Tomas-Kuchta-FPV/VESC6_OPEN_HARDWARE/BOM.csv

Index | LCSC# | MPN | Manufacturer | Package | Customer # | Description | Quantity | MOQ | Multiple | Unit Price($) | Extended Price($) | Product Link
1 | C22775 | 0603WAF1000T5E | UNI-ROYAL | 603 |  | 100Ω ±1% 100mW 0603 Thick Film Resistor | 100 | 100 | 100 | 0 | 0 | https://www.lcsc.com/product-detail/C22775.html
2 | C501008 | STL130N6F7 | ST | PowerFLAT-5x6 |  | N-Channel 60V 130A 125W Surface Mount PowerFLAT-5x6 | 12 | 1 | 1 | 0.9575 | 11.49 | https://www.lcsc.com/product-detail/C501008.html
3 | C22787 | 0603WAF1200T5E | UNI-ROYAL | 603 |  | 120Ω ±1% 100mW 0603 Thick Film Resistor | 100 | 100 | 100 | 0.0019 | 0.19 | https://www.lcsc.com/product-detail/C22787.html
4 | C22978 | 0603WAF3301T5E | UNI-ROYAL | 603 |  | 3.3kΩ ±1% 100mW 0603 Thick Film Resistor | 100 | 100 | 100 | 0.0022 | 0.22 | https://www.lcsc.com/product-detail/C22978.html
5 | C25810 | 0603WAF1802T5E | UNI-ROYAL | 603 |  | 18kΩ ±1% 100mW 0603 Thick Film Resistor | 100 | 100 | 100 | 0 | 0 | https://www.lcsc.com/product-detail/C25810.html
6 | C22809 | 0603WAF1502T5E | UNI-ROYAL | 603 |  | 15kΩ ±1% 100mW 0603 Thick Film Resistor | 100 | 100 | 100 | 0.0029 | 0.29 | https://www.lcsc.com/product-detail/C22809.html
7 | C25804 | 0603WAF1002T5E | UNI-ROYAL | 603 |  | 10kΩ ±1% 100mW 0603 Thick Film Resistor | 100 | 100 | 100 | 0.0022 | 0.22 | https://www.lcsc.com/product-detail/C25804.html
8 | C22961 | 0603WAF2203T5E | UNI-ROYAL | 603 |  | 220kΩ ±1% 100mW 0603 Thick Film Resistor | 100 | 100 | 100 | 0 | 0 | https://www.lcsc.com/product-detail/C22961.html
9 | C23153 | 0603WAF3902T5E | UNI-ROYAL | 603 |  | 39kΩ ±1% 100mW 0603 Thick Film Resistor | 100 | 100 | 100 | 0.0023 | 0.23 | https://www.lcsc.com/product-detail/C23153.html
10 | C4190 | 0603WAF2201T5E | UNI-ROYAL | 603 |  | 2.2kΩ ±1% 100mW 0603 Thick Film Resistor | 100 | 100 | 100 | 0.0018 | 0.18 | https://www.lcsc.com/product-detail/C4190.html
11 | C469426 | ASR-M-3-0.5F | Yezhan | 2512 |  | 6W 0.5mΩ Shunt ±1% ±115ppm/℃ 2512 Chip Resistor - Surface Mount | 10 | 5 | 5 | 0.2714 | 2.71 | https://www.lcsc.com/product-detail/C469426.html
12 | C23164 | 0603WAF470KT5E | UNI-ROYAL | 603 |  | 4.7Ω ±1% 100mW 0603 Thick Film Resistor | 100 | 100 | 100 | 0.0027 | 0.27 | https://www.lcsc.com/product-detail/C23164.html
13 | C160392 | BM06B-SRSS-TB(LF)(SN) | JST | SMD,P=1mm |  | Connector Header 6 position 1mm Pitch 1A Surface Mount,Vertical -25℃~+85℃ | 5 | 5 | 5 | 0.3548 | 1.77 | https://www.lcsc.com/product-detail/C160392.html
14 | C76589 | NTCG163JF103FT1 | TDK | 603 |  | NTC Thermistor 10kΩ Surface Mount 0603 | 5 | 5 | 5 | 0.2086 | 1.04 | https://www.lcsc.com/product-detail/C76589.html
15 | C84375 | RC0805FR-075K1L | YAGEO | 805 |  | 5.1kΩ 125mW 150V Thick Film Resistor ±100ppm/℃ ±1% 0805 Chip Resistor - Surface Mount RoHS | 100 | 100 | 100 | 0.0072 | 0.72 | https://www.lcsc.com/product-detail/C84375.html
16 | C23345 | 0603WAF220JT5E | UNI-ROYAL | 603 |  | 22Ω ±1% 100mW 0603 Thick Film Resistor | 100 | 100 | 100 | 0.0017 | 0.17 | https://www.lcsc.com/product-detail/C23345.html
17 | C124020 | TJA1051TK/3,118 | NXP | HVSON-8-EP(3x3) |  | 4.5V~5.5V CAN FD Transceiver 5Mbps HVSON-8-EP(3x3) Drivers, Receivers, Transceivers RoHS | 2 | 1 | 1 | 1.9139 | 3.83 | https://www.lcsc.com/product-detail/C124020.html
18 | C477918 | LM3671MFX-3.3/NOPB | TI | SOT-23-5 |  | 2MHz Step-down type Fixed 3.3V 600mA SOT-23-5 Voltage Regulators - DC DC Switching Regulators RoHS | 2 | 1 | 1 | 1.0763 | 2.15 | https://www.lcsc.com/product-detail/C477918.html
19 | C98969 | DRV8301DCAR | TI | HTSSOP-56-6mm |  | Three Phase 6V~60V MOSFET 1.7A 25ns 25ns 2.3A HTSSOP-56-6mm Motor Drivers, Controllers RoHS | 2 | 1 | 1 | 4.4178 | 8.84 | https://www.lcsc.com/product-detail/C98969.html
20 | C495342 | AD8418WBRZ-RL | ADI | SOIC-8 |  | 1 -2V~70V 200uV 1V/us 100dB 2.6mA 20V/V SOIC-8 Instrumentation, Op Amps, Buffer Amps RoHS | 6 | 1 | 1 | 5.6955 | 34.17 | https://www.lcsc.com/product-detail/C495342.html
21 | C2827654 | USBLC6-2SC6 | TECH PUBLIC | SOT-23-6 |  | 12VC Clamp 6A Ipp ESD DIODE SOT-23-6 | 10 | 10 | 10 | 0.0452 | 0.45 | https://www.lcsc.com/product-detail/C2827654.html
22 | C15742 | STM32F405RGT6 | ST | LQFP-64(10x10) |  | ARM Cortex-M4 32 Bit 168MHz LQFP-64(10x10) Microcontrollers RoHS | 2 | 1 | 1 | 6.946 | 13.89 | https://www.lcsc.com/product-detail/C15742.html
23 | C115962 | X50328MSB2GI | YXC Crystal Oscillators | SMD5032-2P |  | Crystal 8MHz ±10ppm 20pF SMD5032-2P | 10 | 10 | 10 | 0.2488 | 2.49 | https://www.lcsc.com/product-detail/C115962.html
24 | C2923951 | DSS26 | JSCJ | SOD-123FL |  | Diode Independent 60V 2A Surface Mount SOD-123FL | 10 | 10 | 10 | 0.0518 | 0.52 | https://www.lcsc.com/product-detail/C2923951.html
25 | C1631 | 0603B682K500NT | FH | 603 |  | 6.8nF ±10% 50V Ceramic Capacitor X7R 0603 | 100 | 100 | 100 | 0.0056 | 0.56 | https://www.lcsc.com/product-detail/C1631.html
26 | C107035 | CC0603JRNPO9BN121 | YAGEO | 603 |  | 120pF ±5% 50V Ceramic Capacitor NP0 0603 | 100 | 100 | 100 | 0.0053 | 0.53 | https://www.lcsc.com/product-detail/C107035.html
27 | C21122 | CL10B223KB8NNNC | Samsung Electro-Mechanics | 603 |  | 22nF ±10% 50V Ceramic Capacitor X7R 0603 | 50 | 50 | 50 | 0.0058 | 0.29 | https://www.lcsc.com/product-detail/C21122.html
28 | C16133 | TAJB107K006RNJ | Kyocera AVX | CASE-B-3528-21(mm) |  | 100uF ±10% 6.3V Tantalum Capacitors 1.7Ω@100kHz CASE-B-3528-21(mm) | 4 | 2 | 2 | 0.5706 | 2.28 | https://www.lcsc.com/product-detail/C16133.html
29 | C1596 | 0603B153K500NT | FH | 603 |  | 15nF ±10% 50V Ceramic Capacitor X7R 0603 | 50 | 50 | 50 | 0.0094 | 0.47 | https://www.lcsc.com/product-detail/C1596.html
30 | C385987 | HMK325C7475KM-PE | Taiyo Yuden | 1210 |  | 4.7uF ±10% 100V Ceramic Capacitor X7S 1210 | 20 | 5 | 5 | 0.3209 | 6.42 | https://www.lcsc.com/product-detail/C385987.html
31 | C21120 | CL10B224KA8NNNC | Samsung Electro-Mechanics | 603 |  | 220nF ±10% 25V Ceramic Capacitor X7R 0603 | 50 | 50 | 50 | 0.0094 | 0.47 | https://www.lcsc.com/product-detail/C21120.html
32 | C14663 | CC0603KRX7R9BB104 | YAGEO | 603 |  | 100nF ±10% 50V Ceramic Capacitor X7R 0603 | 50 | 50 | 50 | 0.0087 | 0.44 | https://www.lcsc.com/product-detail/C14663.html
33 | C53987 | 0603B472K500NT | FH | 603 |  | 4.7nF ±10% 50V Ceramic Capacitor X7R 0603 | 50 | 50 | 50 | 0.0054 | 0.27 | https://www.lcsc.com/product-detail/C53987.html
34 | C1644 | CL10C150JB8NNNC | Samsung Electro-Mechanics | 603 |  | 15pF ±5% 50V Ceramic Capacitor C0G 0603 | 50 | 50 | 50 | 0.0112 | 0.56 | https://www.lcsc.com/product-detail/C1644.html
35 | C7471900 | 189RV0038 | KNSCHA | SMD,D10xL10.5mm |  | 220uF ±20% 63V Aluminum Electrolytic Capacitors 2000hrs@105℃ | 5 | 5 | 5 | 0.1171 | 0.59 | https://www.lcsc.com/product-detail/C7471900.html
36 | C23630 | CL10A225KO8NNNC | Samsung Electro-Mechanics | 603 |  | 2.2uF ±10% 16V Ceramic Capacitor X5R 0603 | 50 | 50 | 50 | 0.0123 | 0.62 | https://www.lcsc.com/product-detail/C23630.html
37 | C129544 | SMAJ5.0A-TP | MCC | DO-214AC(SMA) |  | 9.2VC Clamp 43.5A@10/1000us Ipp TVS DIODE DO-214AC(SMA) | 5 | 5 | 5 | 0.1112 | 0.56 | https://www.lcsc.com/product-detail/C129544.html
38 | C2286 | KT-0603R | Hubei KENTO Elec | 603 |  | Red 645nm LED Indication - Discrete 2.4V 0603 | 100 | 100 | 100 | 0.0077 | 0.77 | https://www.lcsc.com/product-detail/C2286.html
39 | C2290 | KT-0603W | Hubei KENTO Elec | 603 |  | White LED Indication - Discrete 2.6V~3.1V 0603 | 50 | 50 | 50 | 0.0123 | 0.62 | https://www.lcsc.com/product-detail/C2290.html
40 | C165948 | TYPE-C-31-M-12 | Korean Hroparts Elec | SMD |  | USB-C (USB TYPE-C) Receptacle Connector 16 Position Surface Mount | 5 | 5 | 5 | 0.1736 | 0.87 | https://www.lcsc.com/product-detail/C165948.html
41 | C383398 | MLZ2012A2R2WT000 | TDK | 805 |  | 650mA 2.2uH ±20% 210mA 150mΩ Multilayer inductor 0805 Fixed Inductors RoHS | 10 | 10 | 10 | 0.0483 | 0.48 | https://www.lcsc.com/product-detail/C383398.html
42 | C266430 | SMNR6028-220MT | Shun Xiang Nuo | SMD,6x6mm |  | 1.45A 22uH ±20% 1.45A 182mΩ Magnetic Shielded Inductor SMD,6x6mm Fixed Inductors | 5 | 5 | 5 | 0.0869 | 0.43 | https://www.lcsc.com/product-detail/C266430.html
43 | C7200700 | 8730 | Keystone | - |  | Tin 15A Brass M2.5 Screw Connectors RoHS | 8 | 1 | 1 | 0.7112 | 5.69 | https://www.lcsc.com/product-detail/C7200700.html
44 | C160404 | SM04B-SRSS-TB(LF)(SN) | JST | SMD,P=1mm,Surface Mount,Right Angle |  | Connector Header 4 position 1mm Pitch 1A Surface Mount, Right Angle -25℃~+85℃ | 5 | 5 | 5 | 0.2168 | 1.08 | https://www.lcsc.com/product-detail/C160404.html
45 | C160405 | SM06B-SRSS-TB(LF)(SN) | JST | SMD,P=1mm,Surface Mount,Right Angle |  | Connector Header 6 position 1mm Pitch 1A Surface Mount, Right Angle -25℃~+85℃ | 3 | 1 | 1 | 0.9021 | 2.71 | https://www.lcsc.com/product-detail/C160405.html
46 | C160390 | BM04B-SRSS-TB(LF)(SN) | JST | SMD,P=1mm |  | Connector Header 4 position 1mm Pitch 1A Surface Mount,Vertical -25℃~+85℃ | 5 | 5 | 5 | 0.2559 | 1.28 | https://www.lcsc.com/product-detail/C160390.html
 |  |  |  |  |  | LCSC Shipping |  |  |  |  | 13.24
 |  |  |  |  |  | LCSC VAT and taxes |  |  |  |  | 38.85
 |  |  |  |  |  | JLCPCB |  |  |  |  | 38.42
 |  |  |  |  |  | JLCPCB Shipping |  |  |  |  | 11.86
 |  |  |  |  |  | JLCPCB tarif |  |  |  |  | 21.76
