Tomas-Kuchta-FPV/VESC6_OPEN_HARDWARE/VESC6_OPEN_HARDWARE.kicad_pcb

## KiCad design VESC6_OPEN_HARDWARE.kicad_pcb (2026-10-29)

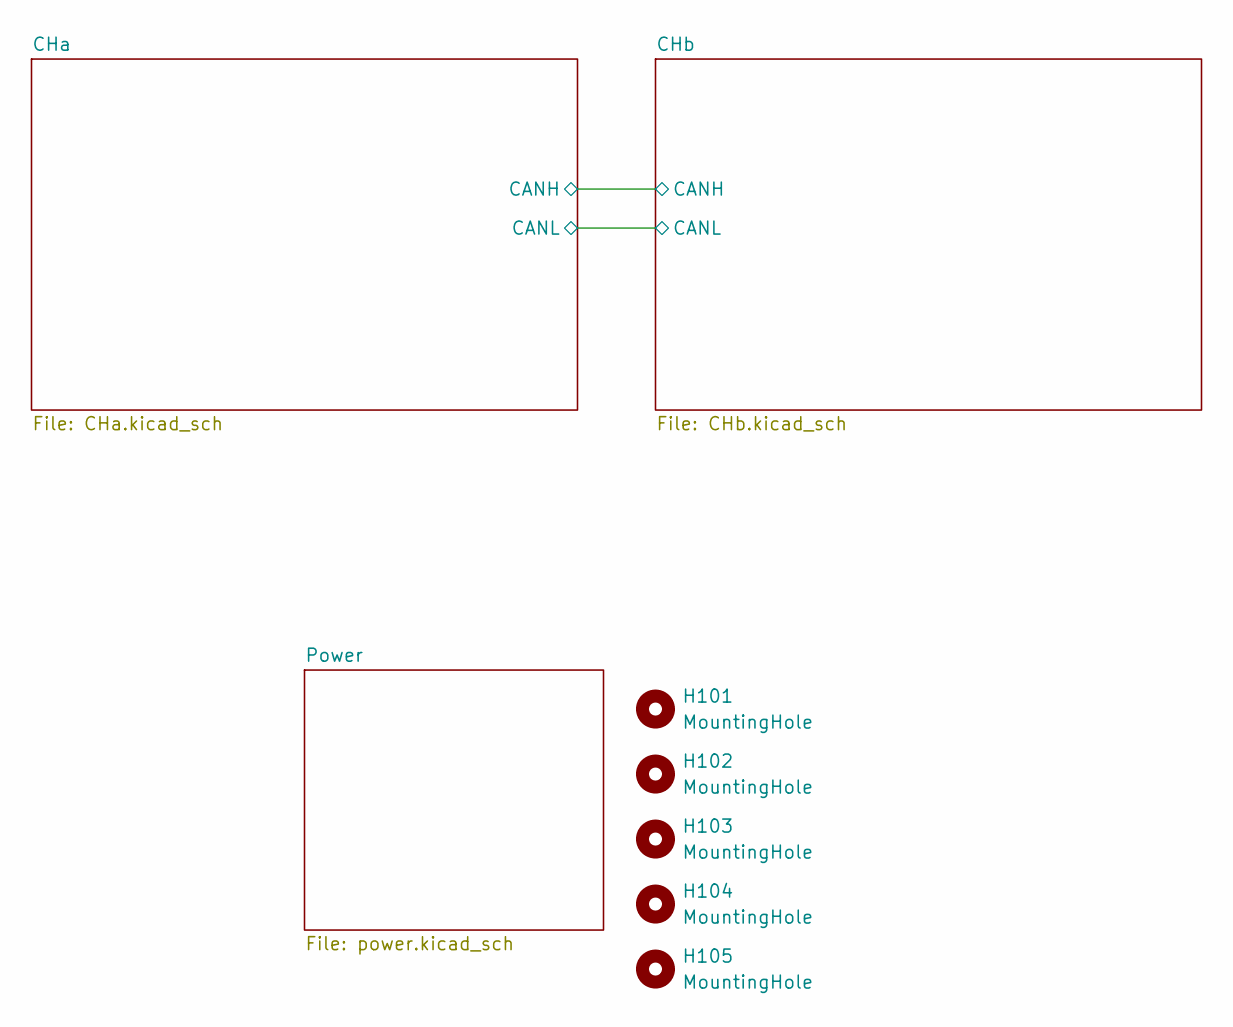
[picture p3: schematic VESC6_OPEN_HARDWARE.kicad_sch]

Parts:
H101, H102, H103, H104, H105: MountingHole; MountingHole_3mm

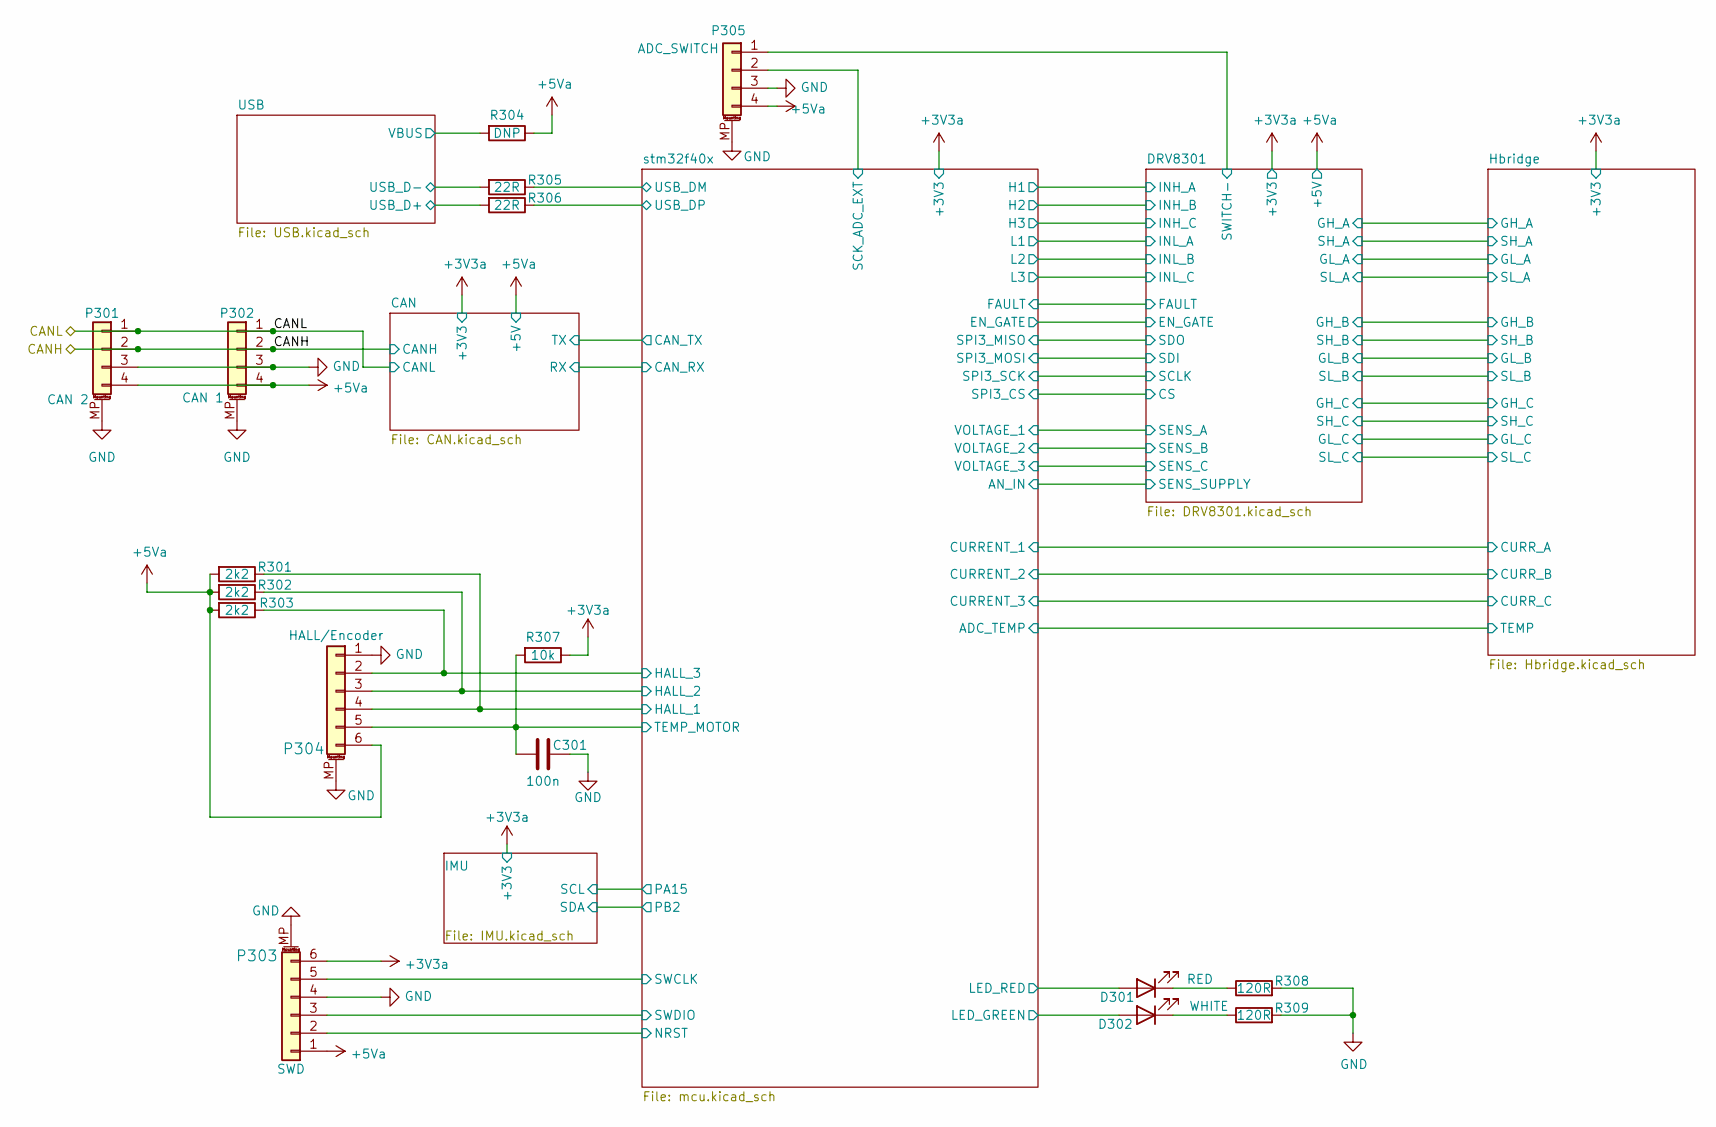
[picture p4: schematic CHa.kicad_sch]

Parts:
C301: 100n; C_0603_1608Metric; LCSC C14663
D301: RED; D_0603_1608Metric; LCSC C2286
D302: WHITE; D_0603_1608Metric; LCSC C2290
P301: CAN 2; JST_SH_SM04B-SRSS-TB_1x04-1MP_P1.00mm_Horizontal; LCSC C160404
P302: CAN 1; JST_SH_SM04B-SRSS-TB_1x04-1MP_P1.00mm_Horizontal; LCSC C160404
P303: SWD; JST_SH_SM06B-SRSS-TB_1x06-1MP_P1.00mm_Horizontal; LCSC C160405
P304: HALL/Encoder; JST_SH_SM06B-SRSS-TB_1x06-1MP_P1.00mm_Horizontal; LCSC C160405
P305: ADC_SWITCH; JST_SH_SM04B-SRSS-TB_1x04-1MP_P1.00mm_Horizontal; LCSC C160404
R301, R302, R303: 2k2; R_0603_1608Metric; LCSC C4190
R304: DNP; R_0603_1608Metric
R305, R306: 22R; R_0603_1608Metric; LCSC C23345
R307: 10k; R_0603_1608Metric; LCSC C25804
R308, R309: 120R; R_0603_1608Metric; LCSC C22787

Connections:
+3V3a: P303.6, R307.1; also elsewhere on the board
+5Va: P301.4, P302.4, P303.1, P304.6, P305.4, R301.2, R302.2, R303.2, R304.1; also elsewhere on the board
/CHa/CANH: P301.2, P302.2; also elsewhere on the board
/CHa/CANL: P301.1, P302.1; also elsewhere on the board
/CHa/DRV8301/SWITCH-: P305.1; also elsewhere on the board
/CHa/USB/USB_D+: R306.2; also elsewhere on the board
/CHa/USB/USB_D-: R305.2; also elsewhere on the board
/CHa/USB/VBUS: R304.2; also elsewhere on the board
/CHa/stm32f40x/HALL_1: P304.4, R301.1; also elsewhere on the board
/CHa/stm32f40x/HALL_2: P304.3, R302.1; also elsewhere on the board
/CHa/stm32f40x/HALL_3: P304.2, R303.1; also elsewhere on the board
/CHa/stm32f40x/LED_GREEN: D302.2 (A); also elsewhere on the board
/CHa/stm32f40x/LED_RED: D301.2 (A); also elsewhere on the board
/CHa/stm32f40x/NRST: P303.2; also elsewhere on the board
/CHa/stm32f40x/SCK_ADC_EXT: P305.2; also elsewhere on the board
/CHa/stm32f40x/SWCLK: P303.5; also elsewhere on the board
/CHa/stm32f40x/SWDIO: P303.3; also elsewhere on the board
/CHa/stm32f40x/TEMP_MOTOR: C301.2, P304.5, R307.2; also elsewhere on the board
/CHa/stm32f40x/USB_DM: R305.1; also elsewhere on the board
/CHa/stm32f40x/USB_DP: R306.1; also elsewhere on the board
GND: C301.1, P301.3, P301.MP (MountPin), P302.3, P302.MP (MountPin), P303.4, P303.MP (MountPin), P304.1, P304.MP (MountPin), P305.3, P305.MP (MountPin), R308.2, R309.2; also elsewhere on the board
unnamed: D301.1 (K), R308.1
unnamed: D302.1 (K), R309.1

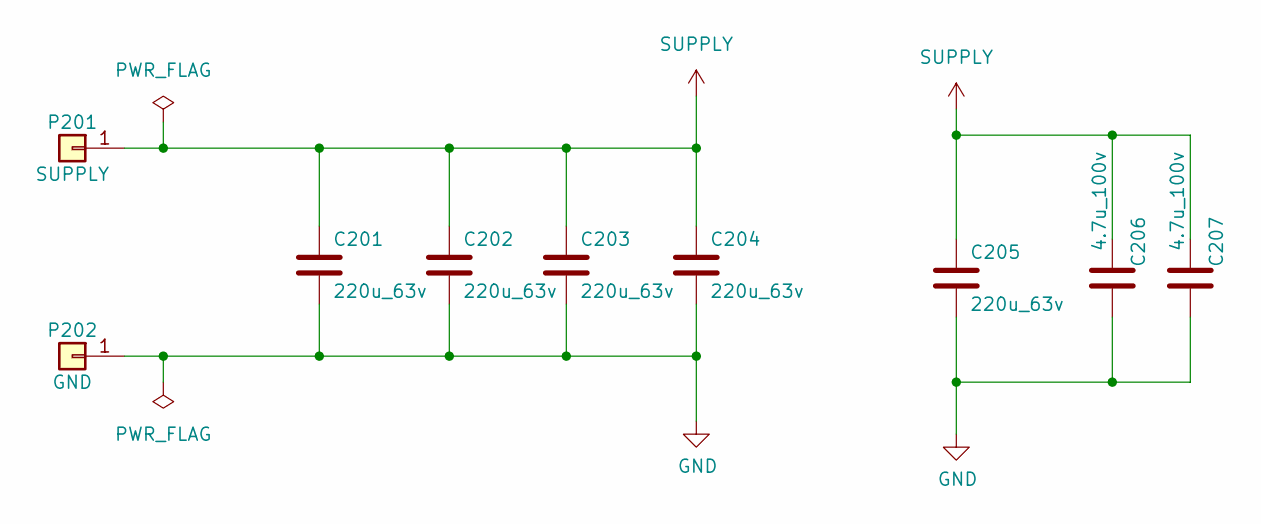
[picture p5: schematic power.kicad_sch]

Parts:
C201, C202, C203, C204, C205: 220u_63v; CP_Elec_10x10.5; LCSC C7471900
C206, C207: 4.7u_100v; C_1210_3225Metric; LCSC C385987
P201: SUPPLY; Pin_D1.3mm_L11.0mm_LooseFit; LCSC C7200700
P202: GND; Pin_D1.3mm_L11.0mm_LooseFit; LCSC C7200700

Connections:
GND: C201.2, C202.2, C203.2, C204.2, C205.2, C206.2, C207.2, P202.1 (Pin_1_1); also elsewhere on the board
SUPPLY: C201.1, C202.1, C203.1, C204.1, C205.1, C206.1, C207.1, P201.1 (Pin_1_1); also elsewhere on the board

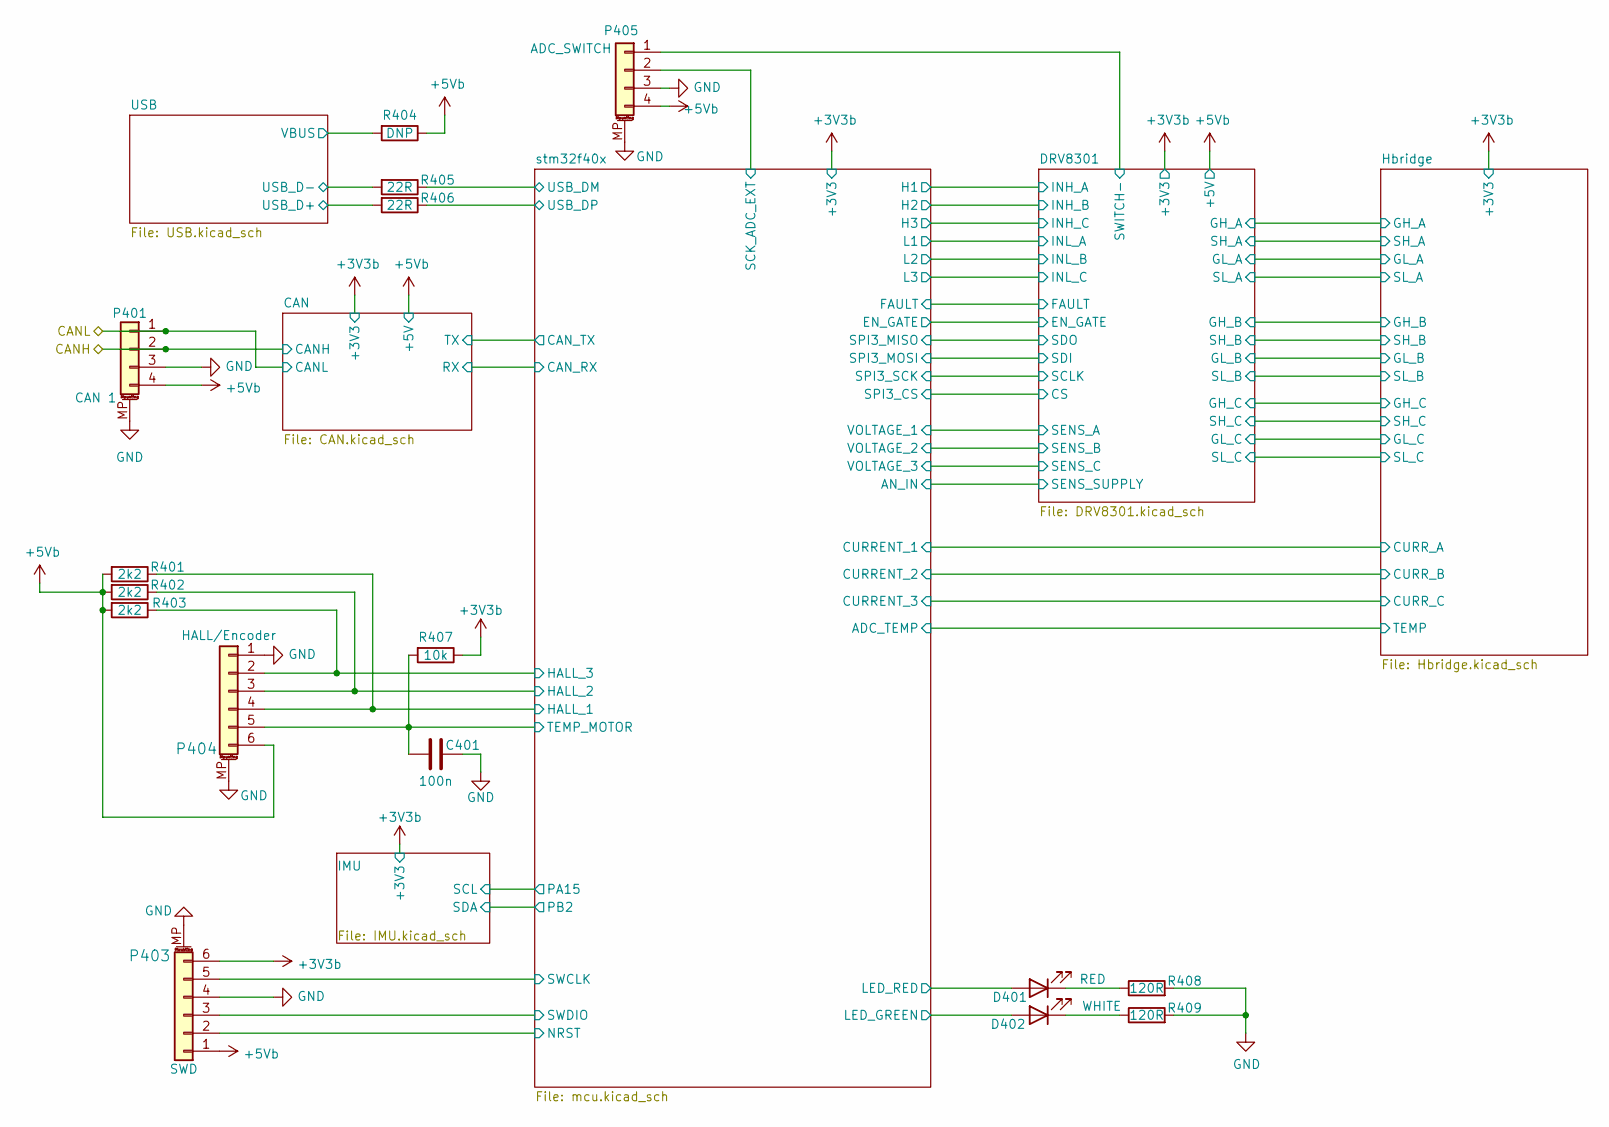
[picture p6: schematic CHb.kicad_sch]

Parts:
C401: 100n; C_0603_1608Metric; LCSC C14663
D401: RED; D_0603_1608Metric; LCSC C2286
D402: WHITE; D_0603_1608Metric; LCSC C2290
P401: CAN 1; JST_SH_BM04B-SRSS-TB_1x04-1MP_P1.00mm_Vertical; LCSC C160390
P403: SWD; JST_SH_BM06B-SRSS-TB_1x06-1MP_P1.00mm_Vertical; LCSC C160392
P404: HALL/Encoder; JST_SH_SM06B-SRSS-TB_1x06-1MP_P1.00mm_Horizontal; LCSC C160405
P405: ADC_SWITCH; JST_SH_BM04B-SRSS-TB_1x04-1MP_P1.00mm_Vertical; LCSC C160390
R401, R402, R403: 2k2; R_0603_1608Metric; LCSC C4190
R404: DNP; R_0603_1608Metric
R405, R406: 22R; R_0603_1608Metric; LCSC C23345
R407: 10k; R_0603_1608Metric; LCSC C25804
R408, R409: 120R; R_0603_1608Metric; LCSC C22787

Connections:
+3V3b: P403.6, R407.1; also elsewhere on the board
+5Vb: P401.4, P403.1, P404.6, P405.4, R401.2, R402.2, R403.2, R404.1; also elsewhere on the board
/CHa/CANH: P401.2; also elsewhere on the board
/CHa/CANL: P401.1; also elsewhere on the board
/CHb/DRV8301/SWITCH-: P405.1; also elsewhere on the board
/CHb/USB/USB_D+: R406.2; also elsewhere on the board
/CHb/USB/USB_D-: R405.2; also elsewhere on the board
/CHb/USB/VBUS: R404.2; also elsewhere on the board
/CHb/stm32f40x/HALL_1: P404.4, R401.1; also elsewhere on the board
/CHb/stm32f40x/HALL_2: P404.3, R402.1; also elsewhere on the board
/CHb/stm32f40x/HALL_3: P404.2, R403.1; also elsewhere on the board
/CHb/stm32f40x/LED_GREEN: D402.2 (A); also elsewhere on the board
/CHb/stm32f40x/LED_RED: D401.2 (A); also elsewhere on the board
/CHb/stm32f40x/NRST: P403.2; also elsewhere on the board
/CHb/stm32f40x/SCK_ADC_EXT: P405.2; also elsewhere on the board
/CHb/stm32f40x/SWCLK: P403.5; also elsewhere on the board
/CHb/stm32f40x/SWDIO: P403.3; also elsewhere on the board
/CHb/stm32f40x/TEMP_MOTOR: C401.2, P404.5, R407.2; also elsewhere on the board
/CHb/stm32f40x/USB_DM: R405.1; also elsewhere on the board
/CHb/stm32f40x/USB_DP: R406.1; also elsewhere on the board
GND: C401.1, P401.3, P401.MP (MountPin), P403.4, P403.MP (MountPin), P404.1, P404.MP (MountPin), P405.3, P405.MP (MountPin), R408.2, R409.2; also elsewhere on the board
unnamed: D401.1 (K), R408.1
unnamed: D402.1 (K), R409.1

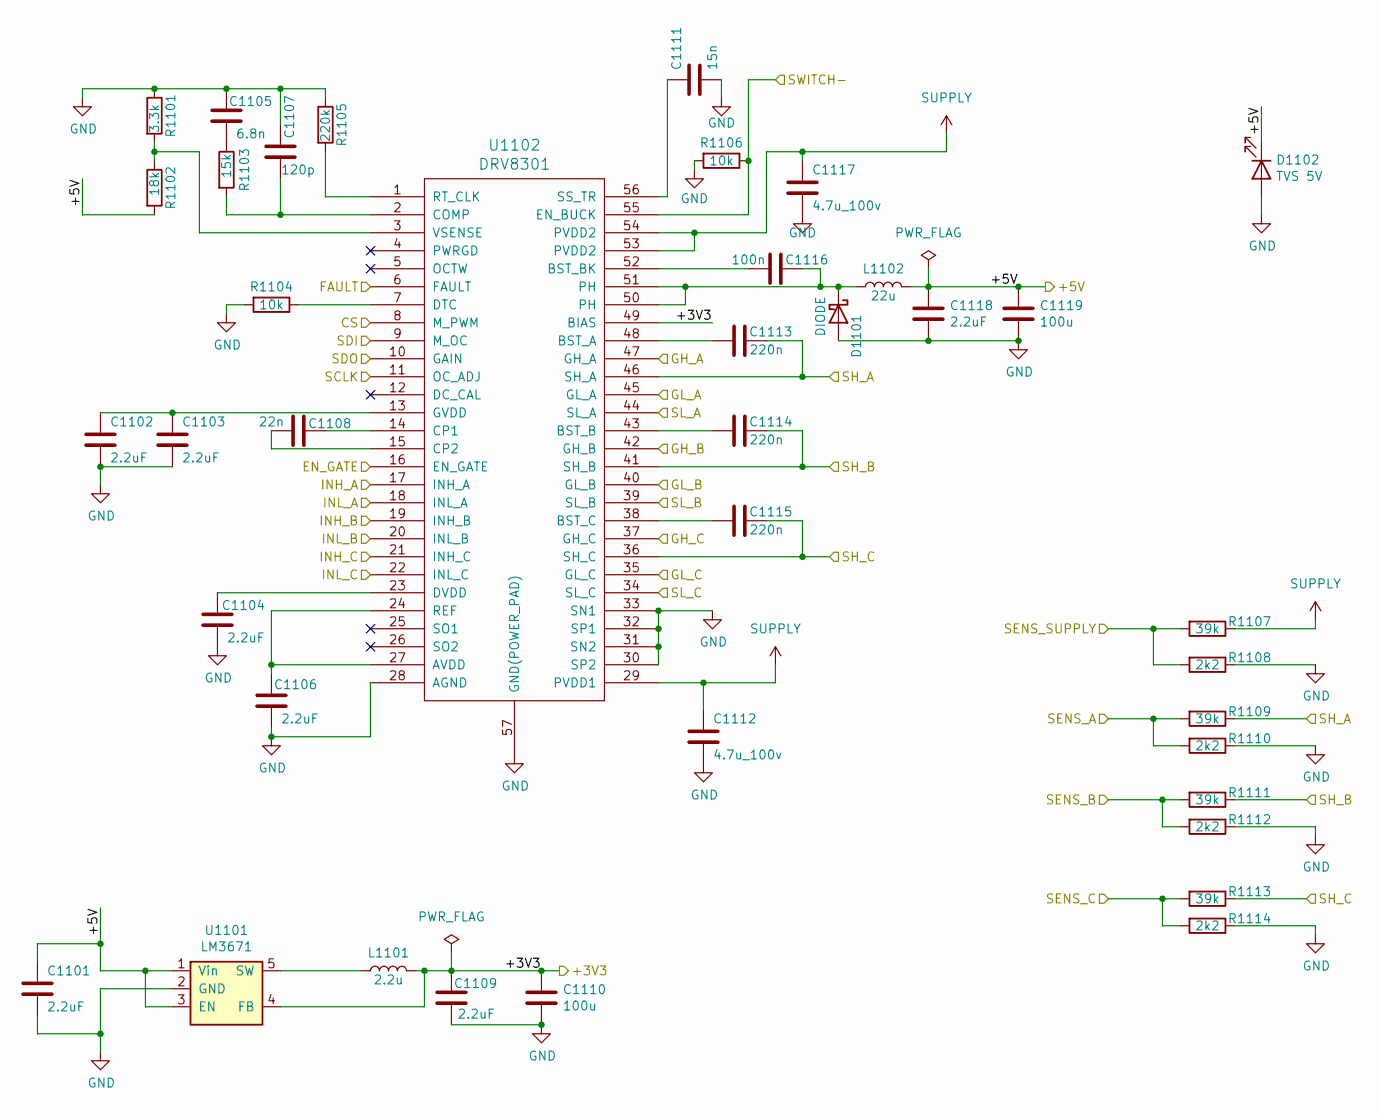
[picture p7: schematic DRV8301.kicad_sch]

Parts:
C1101, C1102, C1103, C1104, C1106, C1109, C1118: 2.2uF; C_0603_1608Metric; LCSC C23630
C1105: 6.8n; C_0603_1608Metric; LCSC C1631
C1107: 120p; C_0603_1608Metric; LCSC C107035
C1108: 22n; C_0603_1608Metric; LCSC C21122
C1110, C1119: 100u; C_1210_3225Metric; LCSC C16133
C1111: 15n; C_0603_1608Metric; LCSC C1596
C1112, C1117: 4.7u_100v; C_1210_3225Metric; LCSC C385987
C1113, C1114, C1115: 220n; C_0603_1608Metric; LCSC C21120
C1116: 100n; C_0603_1608Metric; LCSC C14663
D1101: DIODE; D_SMF; LCSC C2923951
D1102: TVS 5V; D_SMA; LCSC C129544
L1101: 2.2u; L_0805_2012Metric; LCSC C383398
L1102: 22u; L_Taiyo-Yuden_NR-60xx_HandSoldering; LCSC C266430
R1101: 3.3k; R_0603_1608Metric; LCSC C22978
R1102: 18k; R_0603_1608Metric; LCSC C25810
R1103: 15k; R_0603_1608Metric; LCSC C22809
R1104, R1106: 10k; R_0603_1608Metric; LCSC C25804
R1105: 220k; R_0603_1608Metric; LCSC C22961
R1107, R1109, R1111, R1113: 39k; R_0603_1608Metric; LCSC C23153
R1108, R1110, R1112, R1114: 2k2; R_0603_1608Metric; LCSC C4190
U1101: LM3671; SOT-23-5; LCSC C477918
U1102: DRV8301; HTSSOP-56-1EP_6.1x14mm_P0.5mm_EP3.61x6.35mm; LCSC C98969

Connections:
+3V3a: C1109.1, C1110.1, L1101.2, U1101.4 (FB), U1102.49 (BIAS); also elsewhere on the board
+5Va: C1101.1, C1118.1, C1119.1, D1102.1 (K), L1102.2, R1102.2, U1101.1 (Vin), U1101.3 (EN); also elsewhere on the board
/CHa/DRV8301/CS: U1102.8 (M_PWM); also elsewhere on the board
/CHa/DRV8301/EN_GATE: U1102.16 (EN_GATE); also elsewhere on the board
/CHa/DRV8301/FAULT: U1102.6 (FAULT); also elsewhere on the board
/CHa/DRV8301/GH_A: U1102.47 (GH_A); also elsewhere on the board
/CHa/DRV8301/GH_B: U1102.42 (GH_B); also elsewhere on the board
/CHa/DRV8301/GH_C: U1102.37 (GH_C); also elsewhere on the board
/CHa/DRV8301/GL_A: U1102.45 (GL_A); also elsewhere on the board
/CHa/DRV8301/GL_B: U1102.40 (GL_B); also elsewhere on the board
/CHa/DRV8301/GL_C: U1102.35 (GL_C); also elsewhere on the board
/CHa/DRV8301/INH_A: U1102.17 (INH_A); also elsewhere on the board
/CHa/DRV8301/INH_B: U1102.19 (INH_B); also elsewhere on the board
/CHa/DRV8301/INH_C: U1102.21 (INH_C); also elsewhere on the board
/CHa/DRV8301/INL_A: U1102.18 (INL_A); also elsewhere on the board
/CHa/DRV8301/INL_B: U1102.20 (INL_B); also elsewhere on the board
/CHa/DRV8301/INL_C: U1102.22 (INL_C); also elsewhere on the board
/CHa/DRV8301/SCLK: U1102.11 (OC_ADJ); also elsewhere on the board
/CHa/DRV8301/SDI: U1102.9 (M_OC); also elsewhere on the board
/CHa/DRV8301/SDO: U1102.10 (GAIN); also elsewhere on the board
/CHa/DRV8301/SENS_A: R1109.2, R1110.2; also elsewhere on the board
/CHa/DRV8301/SENS_B: R1111.2, R1112.2; also elsewhere on the board
/CHa/DRV8301/SENS_C: R1113.2, R1114.2; also elsewhere on the board
/CHa/DRV8301/SENS_SUPPLY: R1107.2, R1108.2; also elsewhere on the board
/CHa/DRV8301/SH_A: C1113.1, R1109.1, U1102.46 (SH_A); also elsewhere on the board
/CHa/DRV8301/SH_B: C1114.1, R1111.1, U1102.41 (SH_B); also elsewhere on the board
/CHa/DRV8301/SH_C: C1115.1, R1113.1, U1102.36 (SH_C); also elsewhere on the board
/CHa/DRV8301/SWITCH-: R1106.1, U1102.55 (EN_BUCK); also elsewhere on the board
GND: C1101.2, C1102.2, C1103.2, C1104.2, C1105.1, C1106.2, C1107.1, C1109.2, C1110.2, C1111.2, C1112.2, C1117.2, C1118.2, C1119.2, D1101.2 (A), D1102.2 (A), R1101.1, R1104.2, R1105.1, R1106.2, R1108.1, R1110.1, R1112.1, R1114.1, U1101.2 (GND), U1102.28 (AGND), U1102.30 (SP2), U1102.31 (SN2), U1102.32 (SP1), U1102.33 (SN1), U1102.34 (SL_C), U1102.39 (SL_B), U1102.44 (SL_A), U1102.57 (GND(POWER_PAD)); also elsewhere on the board
unnamed: C1105.2, R1103.1
unnamed: C1116.1, D1101.1 (K), L1102.1, U1102.50 (PH), U1102.51 (PH)
unnamed: L1101.1, U1101.5 (SW)
unnamed: C1106.1, U1102.24 (REF), U1102.27 (AVDD)
unnamed: C1113.2, U1102.48 (BST_A)
unnamed: C1114.2, U1102.43 (BST_B)
unnamed: C1116.2, U1102.52 (BST_BK)
unnamed: C1115.2, U1102.38 (BST_C)
unnamed: C1107.2, R1103.2, U1102.2 (COMP)
unnamed: C1108.1, U1102.14 (CP1)
unnamed: C1108.2, U1102.15 (CP2)
unnamed: R1104.1, U1102.7 (DTC)
unnamed: C1104.1, U1102.23 (DVDD)
unnamed: C1102.1, C1103.1, U1102.13 (GVDD)
unnamed: R1105.2, U1102.1 (RT_CLK)
unnamed: C1111.1, U1102.56 (SS_TR)
unnamed: R1101.2, R1102.1, U1102.3 (VSENSE)
SUPPLY: C1112.1, C1117.1, R1107.1, U1102.29 (PVDD1), U1102.53 (PVDD2), U1102.54 (PVDD2); also elsewhere on the board

Parts of its further copies:
C2101, C2102, C2103, C2104, C2106, C2109, C2118: 2.2uF; C_0603_1608Metric; LCSC C23630
C2105: 6.8n; C_0603_1608Metric; LCSC C1631
C2107: 120p; C_0603_1608Metric; LCSC C107035
C2108: 22n; C_0603_1608Metric; LCSC C21122
C2110, C2119: 100u; C_1210_3225Metric; LCSC C16133
C2111: 15n; C_0603_1608Metric; LCSC C1596
C2112, C2117: 4.7u_100v; C_1210_3225Metric; LCSC C385987
C2113, C2114, C2115: 220n; C_0603_1608Metric; LCSC C21120
C2116: 100n; C_0603_1608Metric; LCSC C14663
D2101: DIODE; D_SMF; LCSC C2923951
D2102: TVS 5V; D_SMA; LCSC C129544
L2101: 2.2u; L_0805_2012Metric; LCSC C383398
L2102: 22u; L_Taiyo-Yuden_NR-60xx_HandSoldering; LCSC C266430
R2101: 3.3k; R_0603_1608Metric; LCSC C22978
R2102: 18k; R_0603_1608Metric; LCSC C25810
R2103: 15k; R_0603_1608Metric; LCSC C22809
R2104, R2106: 10k; R_0603_1608Metric; LCSC C25804
R2105: 220k; R_0603_1608Metric; LCSC C22961
R2107, R2109, R2111, R2113: 39k; R_0603_1608Metric; LCSC C23153
R2108, R2110, R2112, R2114: 2k2; R_0603_1608Metric; LCSC C4190
U2101: LM3671; SOT-23-5; LCSC C477918
U2102: DRV8301; HTSSOP-56-1EP_6.1x14mm_P0.5mm_EP3.61x6.35mm; LCSC C98969

Connections of its further copies:
+3V3b: C2109.1, C2110.1, L2101.2, U2101.4 (FB), U2102.49 (BIAS); also elsewhere on the board
+5Vb: C2101.1, C2118.1, C2119.1, D2102.1 (K), L2102.2, R2102.2, U2101.1 (Vin), U2101.3 (EN); also elsewhere on the board
/CHb/DRV8301/CS: U2102.8 (M_PWM); also elsewhere on the board
/CHb/DRV8301/EN_GATE: U2102.16 (EN_GATE); also elsewhere on the board
/CHb/DRV8301/FAULT: U2102.6 (FAULT); also elsewhere on the board
/CHb/DRV8301/GH_A: U2102.47 (GH_A); also elsewhere on the board
/CHb/DRV8301/GH_B: U2102.42 (GH_B); also elsewhere on the board
/CHb/DRV8301/GH_C: U2102.37 (GH_C); also elsewhere on the board
/CHb/DRV8301/GL_A: U2102.45 (GL_A); also elsewhere on the board
/CHb/DRV8301/GL_B: U2102.40 (GL_B); also elsewhere on the board
/CHb/DRV8301/GL_C: U2102.35 (GL_C); also elsewhere on the board
/CHb/DRV8301/INH_A: U2102.17 (INH_A); also elsewhere on the board
/CHb/DRV8301/INH_B: U2102.19 (INH_B); also elsewhere on the board
/CHb/DRV8301/INH_C: U2102.21 (INH_C); also elsewhere on the board
/CHb/DRV8301/INL_A: U2102.18 (INL_A); also elsewhere on the board
/CHb/DRV8301/INL_B: U2102.20 (INL_B); also elsewhere on the board
/CHb/DRV8301/INL_C: U2102.22 (INL_C); also elsewhere on the board
/CHb/DRV8301/SCLK: U2102.11 (OC_ADJ); also elsewhere on the board
/CHb/DRV8301/SDI: U2102.9 (M_OC); also elsewhere on the board
/CHb/DRV8301/SDO: U2102.10 (GAIN); also elsewhere on the board
/CHb/DRV8301/SENS_A: R2109.2, R2110.2; also elsewhere on the board
/CHb/DRV8301/SENS_B: R2111.2, R2112.2; also elsewhere on the board
/CHb/DRV8301/SENS_C: R2113.2, R2114.2; also elsewhere on the board
/CHb/DRV8301/SENS_SUPPLY: R2107.2, R2108.2; also elsewhere on the board
/CHb/DRV8301/SH_A: C2113.1, R2109.1, U2102.46 (SH_A); also elsewhere on the board
/CHb/DRV8301/SH_B: C2114.1, R2111.1, U2102.41 (SH_B); also elsewhere on the board
/CHb/DRV8301/SH_C: C2115.1, R2113.1, U2102.36 (SH_C); also elsewhere on the board
/CHb/DRV8301/SWITCH-: R2106.1, U2102.55 (EN_BUCK); also elsewhere on the board
GND: C2101.2, C2102.2, C2103.2, C2104.2, C2105.1, C2106.2, C2107.1, C2109.2, C2110.2, C2111.2, C2112.2, C2117.2, C2118.2, C2119.2, D2101.2 (A), D2102.2 (A), R2101.1, R2104.2, R2105.1, R2106.2, R2108.1, R2110.1, R2112.1, R2114.1, U2101.2 (GND), U2102.28 (AGND), U2102.30 (SP2), U2102.31 (SN2), U2102.32 (SP1), U2102.33 (SN1), U2102.34 (SL_C), U2102.39 (SL_B), U2102.44 (SL_A), U2102.57 (GND(POWER_PAD)); also elsewhere on the board
unnamed: C2105.2, R2103.1
unnamed: C2116.1, D2101.1 (K), L2102.1, U2102.50 (PH), U2102.51 (PH)
unnamed: L2101.1, U2101.5 (SW)
unnamed: C2106.1, U2102.24 (REF), U2102.27 (AVDD)
unnamed: C2113.2, U2102.48 (BST_A)
unnamed: C2114.2, U2102.43 (BST_B)
unnamed: C2116.2, U2102.52 (BST_BK)
unnamed: C2115.2, U2102.38 (BST_C)
unnamed: C2107.2, R2103.2, U2102.2 (COMP)
unnamed: C2108.1, U2102.14 (CP1)
unnamed: C2108.2, U2102.15 (CP2)
unnamed: R2104.1, U2102.7 (DTC)
unnamed: C2104.1, U2102.23 (DVDD)
unnamed: C2102.1, C2103.1, U2102.13 (GVDD)
unnamed: R2105.2, U2102.1 (RT_CLK)
unnamed: C2111.1, U2102.56 (SS_TR)
unnamed: R2101.2, R2102.1, U2102.3 (VSENSE)
SUPPLY: C2112.1, C2117.1, R2107.1, U2102.29 (PVDD1), U2102.53 (PVDD2), U2102.54 (PVDD2); also elsewhere on the board

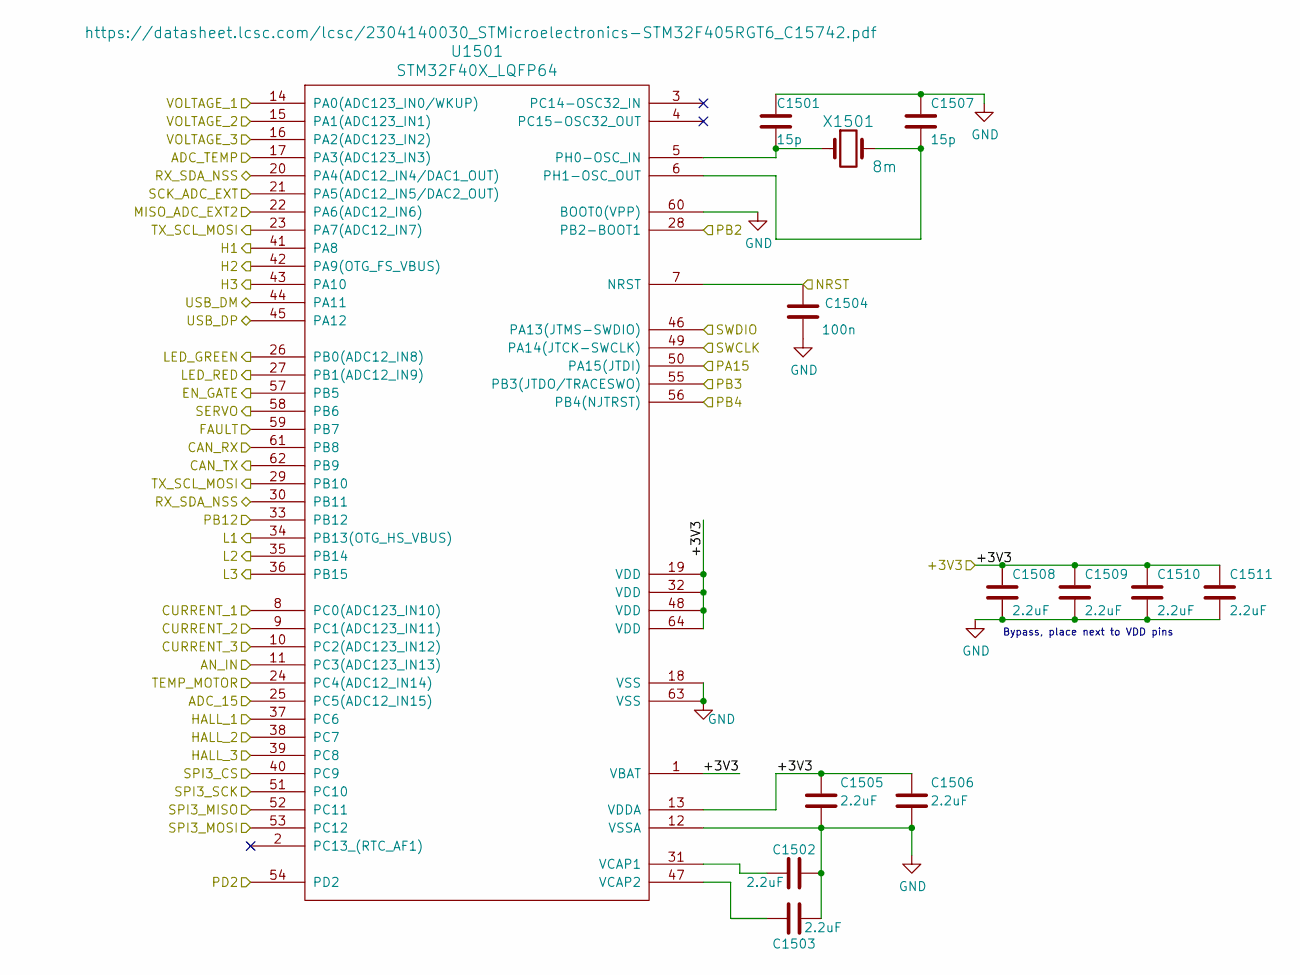
[picture p8: schematic mcu.kicad_sch]

Parts:
C1501, C1507: 15p; C_0603_1608Metric; LCSC C1644
C1502, C1503, C1505, C1506, C1508, C1509, C1510, C1511: 2.2uF; C_0603_1608Metric; LCSC C23630
C1504: 100n; C_0603_1608Metric; LCSC C14663
U1501: STM32F40X_LQFP64; LQFP-64_10x10mm_P0.5mm; LCSC C15742
X1501: 8m; Crystal_SMD_5032-2Pin_5.0x3.2mm; LCSC C115962

Connections:
+3V3a: C1505.1, C1506.1, C1508.1, C1509.1, C1510.1, C1511.1, U1501.1 (VBAT), U1501.13 (VDDA), U1501.19 (VDD), U1501.32 (VDD), U1501.48 (VDD), U1501.64 (VDD); also elsewhere on the board
/CHa/CAN/RX: U1501.61 (PB8); also elsewhere on the board
/CHa/CAN/TX: U1501.62 (PB9); also elsewhere on the board
/CHa/DRV8301/CS: U1501.40 (PC9); also elsewhere on the board
/CHa/DRV8301/EN_GATE: U1501.57 (PB5); also elsewhere on the board
/CHa/DRV8301/FAULT: U1501.59 (PB7); also elsewhere on the board
/CHa/DRV8301/INH_A: U1501.41 (PA8); also elsewhere on the board
/CHa/DRV8301/INH_B: U1501.42 (PA9(OTG_FS_VBUS)); also elsewhere on the board
/CHa/DRV8301/INH_C: U1501.43 (PA10); also elsewhere on the board
/CHa/DRV8301/INL_A: U1501.34 (PB13(OTG_HS_VBUS)); also elsewhere on the board
/CHa/DRV8301/INL_B: U1501.35 (PB14); also elsewhere on the board
/CHa/DRV8301/INL_C: U1501.36 (PB15); also elsewhere on the board
/CHa/DRV8301/SCLK: U1501.51 (PC10); also elsewhere on the board
/CHa/DRV8301/SDI: U1501.53 (PC12); also elsewhere on the board
/CHa/DRV8301/SDO: U1501.52 (PC11); also elsewhere on the board
/CHa/DRV8301/SENS_A: U1501.14 (PA0(ADC123_IN0/WKUP)); also elsewhere on the board
/CHa/DRV8301/SENS_B: U1501.15 (PA1(ADC123_IN1)); also elsewhere on the board
/CHa/DRV8301/SENS_C: U1501.16 (PA2(ADC123_IN2)); also elsewhere on the board
/CHa/DRV8301/SENS_SUPPLY: U1501.11 (PC3(ADC123_IN13)); also elsewhere on the board
/CHa/Hbridge/CURR_A: U1501.8 (PC0(ADC123_IN10)); also elsewhere on the board
/CHa/Hbridge/CURR_B: U1501.9 (PC1(ADC123_IN11)); also elsewhere on the board
/CHa/Hbridge/CURR_C: U1501.10 (PC2(ADC123_IN12)); also elsewhere on the board
/CHa/Hbridge/TEMP: U1501.17 (PA3(ADC123_IN3)); also elsewhere on the board
/CHa/IMU/SCL: U1501.50 (PA15(JTDI)); also elsewhere on the board
/CHa/IMU/SDA: U1501.28 (PB2-BOOT1); also elsewhere on the board
/CHa/stm32f40x/ADC_15: U1501.25 (PC5(ADC12_IN15))
/CHa/stm32f40x/HALL_1: U1501.37 (PC6); also elsewhere on the board
/CHa/stm32f40x/HALL_2: U1501.38 (PC7); also elsewhere on the board
/CHa/stm32f40x/HALL_3: U1501.39 (PC8); also elsewhere on the board
/CHa/stm32f40x/LED_GREEN: U1501.26 (PB0(ADC12_IN8)); also elsewhere on the board
/CHa/stm32f40x/LED_RED: U1501.27 (PB1(ADC12_IN9)); also elsewhere on the board
/CHa/stm32f40x/MISO_ADC_EXT2: U1501.22 (PA6(ADC12_IN6))
/CHa/stm32f40x/NRST: C1504.1, U1501.7 (NRST); also elsewhere on the board
/CHa/stm32f40x/PB3: U1501.55 (PB3(JTDO/TRACESWO))
/CHa/stm32f40x/PB4: U1501.56 (PB4(NJTRST))
/CHa/stm32f40x/PB12: U1501.33 (PB12)
/CHa/stm32f40x/PD2: U1501.54 (PD2)
/CHa/stm32f40x/RX_SDA_NSS: U1501.20 (PA4(ADC12_IN4/DAC1_OUT)), U1501.30 (PB11)
/CHa/stm32f40x/SCK_ADC_EXT: U1501.21 (PA5(ADC12_IN5/DAC2_OUT)); also elsewhere on the board
/CHa/stm32f40x/SERVO: U1501.58 (PB6)
/CHa/stm32f40x/SWCLK: U1501.49 (PA14(JTCK-SWCLK)); also elsewhere on the board
/CHa/stm32f40x/SWDIO: U1501.46 (PA13(JTMS-SWDIO)); also elsewhere on the board
/CHa/stm32f40x/TEMP_MOTOR: U1501.24 (PC4(ADC12_IN14)); also elsewhere on the board
/CHa/stm32f40x/TX_SCL_MOSI: U1501.23 (PA7(ADC12_IN7)), U1501.29 (PB10)
/CHa/stm32f40x/USB_DM: U1501.44 (PA11); also elsewhere on the board
/CHa/stm32f40x/USB_DP: U1501.45 (PA12); also elsewhere on the board
GND: C1501.1, C1502.1, C1503.1, C1504.2, C1505.2, C1506.2, C1507.1, C1508.2, C1509.2, C1510.2, C1511.2, U1501.12 (VSSA), U1501.18 (VSS), U1501.60 (BOOT0(VPP)), U1501.63 (VSS); also elsewhere on the board
unnamed: C1501.2, U1501.5 (PH0-OSC_IN), X1501.1
unnamed: C1507.2, U1501.6 (PH1-OSC_OUT), X1501.2
unnamed: C1502.2, U1501.31 (VCAP1)
unnamed: C1503.2, U1501.47 (VCAP2)

Parts of its further copies:
C2501, C2507: 15p; C_0603_1608Metric; LCSC C1644
C2502, C2503, C2505, C2506, C2508, C2509, C2510, C2511: 2.2uF; C_0603_1608Metric; LCSC C23630
C2504: 100n; C_0603_1608Metric; LCSC C14663
U2501: STM32F40X_LQFP64; LQFP-64_10x10mm_P0.5mm; LCSC C15742
X2501: 8m; Crystal_SMD_5032-2Pin_5.0x3.2mm; LCSC C115962

Connections of its further copies:
+3V3b: C2505.1, C2506.1, C2508.1, C2509.1, C2510.1, C2511.1, U2501.1 (VBAT), U2501.13 (VDDA), U2501.19 (VDD), U2501.32 (VDD), U2501.48 (VDD), U2501.64 (VDD); also elsewhere on the board
/CHb/CAN/RX: U2501.61 (PB8); also elsewhere on the board
/CHb/CAN/TX: U2501.62 (PB9); also elsewhere on the board
/CHb/DRV8301/CS: U2501.40 (PC9); also elsewhere on the board
/CHb/DRV8301/EN_GATE: U2501.57 (PB5); also elsewhere on the board
/CHb/DRV8301/FAULT: U2501.59 (PB7); also elsewhere on the board
/CHb/DRV8301/INH_A: U2501.41 (PA8); also elsewhere on the board
/CHb/DRV8301/INH_B: U2501.42 (PA9(OTG_FS_VBUS)); also elsewhere on the board
/CHb/DRV8301/INH_C: U2501.43 (PA10); also elsewhere on the board
/CHb/DRV8301/INL_A: U2501.34 (PB13(OTG_HS_VBUS)); also elsewhere on the board
/CHb/DRV8301/INL_B: U2501.35 (PB14); also elsewhere on the board
/CHb/DRV8301/INL_C: U2501.36 (PB15); also elsewhere on the board
/CHb/DRV8301/SCLK: U2501.51 (PC10); also elsewhere on the board
/CHb/DRV8301/SDI: U2501.53 (PC12); also elsewhere on the board
/CHb/DRV8301/SDO: U2501.52 (PC11); also elsewhere on the board
/CHb/DRV8301/SENS_A: U2501.14 (PA0(ADC123_IN0/WKUP)); also elsewhere on the board
/CHb/DRV8301/SENS_B: U2501.15 (PA1(ADC123_IN1)); also elsewhere on the board
/CHb/DRV8301/SENS_C: U2501.16 (PA2(ADC123_IN2)); also elsewhere on the board
/CHb/DRV8301/SENS_SUPPLY: U2501.11 (PC3(ADC123_IN13)); also elsewhere on the board
/CHb/Hbridge/CURR_A: U2501.8 (PC0(ADC123_IN10)); also elsewhere on the board
/CHb/Hbridge/CURR_B: U2501.9 (PC1(ADC123_IN11)); also elsewhere on the board
/CHb/Hbridge/CURR_C: U2501.10 (PC2(ADC123_IN12)); also elsewhere on the board
/CHb/Hbridge/TEMP: U2501.17 (PA3(ADC123_IN3)); also elsewhere on the board
/CHb/IMU/SCL: U2501.50 (PA15(JTDI)); also elsewhere on the board
/CHb/IMU/SDA: U2501.28 (PB2-BOOT1); also elsewhere on the board
/CHb/stm32f40x/ADC_15: U2501.25 (PC5(ADC12_IN15))
/CHb/stm32f40x/HALL_1: U2501.37 (PC6); also elsewhere on the board
/CHb/stm32f40x/HALL_2: U2501.38 (PC7); also elsewhere on the board
/CHb/stm32f40x/HALL_3: U2501.39 (PC8); also elsewhere on the board
/CHb/stm32f40x/LED_GREEN: U2501.26 (PB0(ADC12_IN8)); also elsewhere on the board
/CHb/stm32f40x/LED_RED: U2501.27 (PB1(ADC12_IN9)); also elsewhere on the board
/CHb/stm32f40x/MISO_ADC_EXT2: U2501.22 (PA6(ADC12_IN6))
/CHb/stm32f40x/NRST: C2504.1, U2501.7 (NRST); also elsewhere on the board
/CHb/stm32f40x/PB3: U2501.55 (PB3(JTDO/TRACESWO))
/CHb/stm32f40x/PB4: U2501.56 (PB4(NJTRST))
/CHb/stm32f40x/PB12: U2501.33 (PB12)
/CHb/stm32f40x/PD2: U2501.54 (PD2)
/CHb/stm32f40x/RX_SDA_NSS: U2501.20 (PA4(ADC12_IN4/DAC1_OUT)), U2501.30 (PB11)
/CHb/stm32f40x/SCK_ADC_EXT: U2501.21 (PA5(ADC12_IN5/DAC2_OUT)); also elsewhere on the board
/CHb/stm32f40x/SERVO: U2501.58 (PB6)
/CHb/stm32f40x/SWCLK: U2501.49 (PA14(JTCK-SWCLK)); also elsewhere on the board
/CHb/stm32f40x/SWDIO: U2501.46 (PA13(JTMS-SWDIO)); also elsewhere on the board
/CHb/stm32f40x/TEMP_MOTOR: U2501.24 (PC4(ADC12_IN14)); also elsewhere on the board
/CHb/stm32f40x/TX_SCL_MOSI: U2501.23 (PA7(ADC12_IN7)), U2501.29 (PB10)
/CHb/stm32f40x/USB_DM: U2501.44 (PA11); also elsewhere on the board
/CHb/stm32f40x/USB_DP: U2501.45 (PA12); also elsewhere on the board
GND: C2501.1, C2502.1, C2503.1, C2504.2, C2505.2, C2506.2, C2507.1, C2508.2, C2509.2, C2510.2, C2511.2, U2501.12 (VSSA), U2501.18 (VSS), U2501.60 (BOOT0(VPP)), U2501.63 (VSS); also elsewhere on the board
unnamed: C2501.2, U2501.5 (PH0-OSC_IN), X2501.1
unnamed: C2507.2, U2501.6 (PH1-OSC_OUT), X2501.2
unnamed: C2502.2, U2501.31 (VCAP1)
unnamed: C2503.2, U2501.47 (VCAP2)

Notes on the sheet:
Bypass, place next to VDD pins
