Tomas-Kuchta-FPV/VESC6_OPEN_HARDWARE/VESC6_OPEN_HARDWARE.kicad_pcb

## KiCad design VESC6_OPEN_HARDWARE.kicad_pcb (continued)

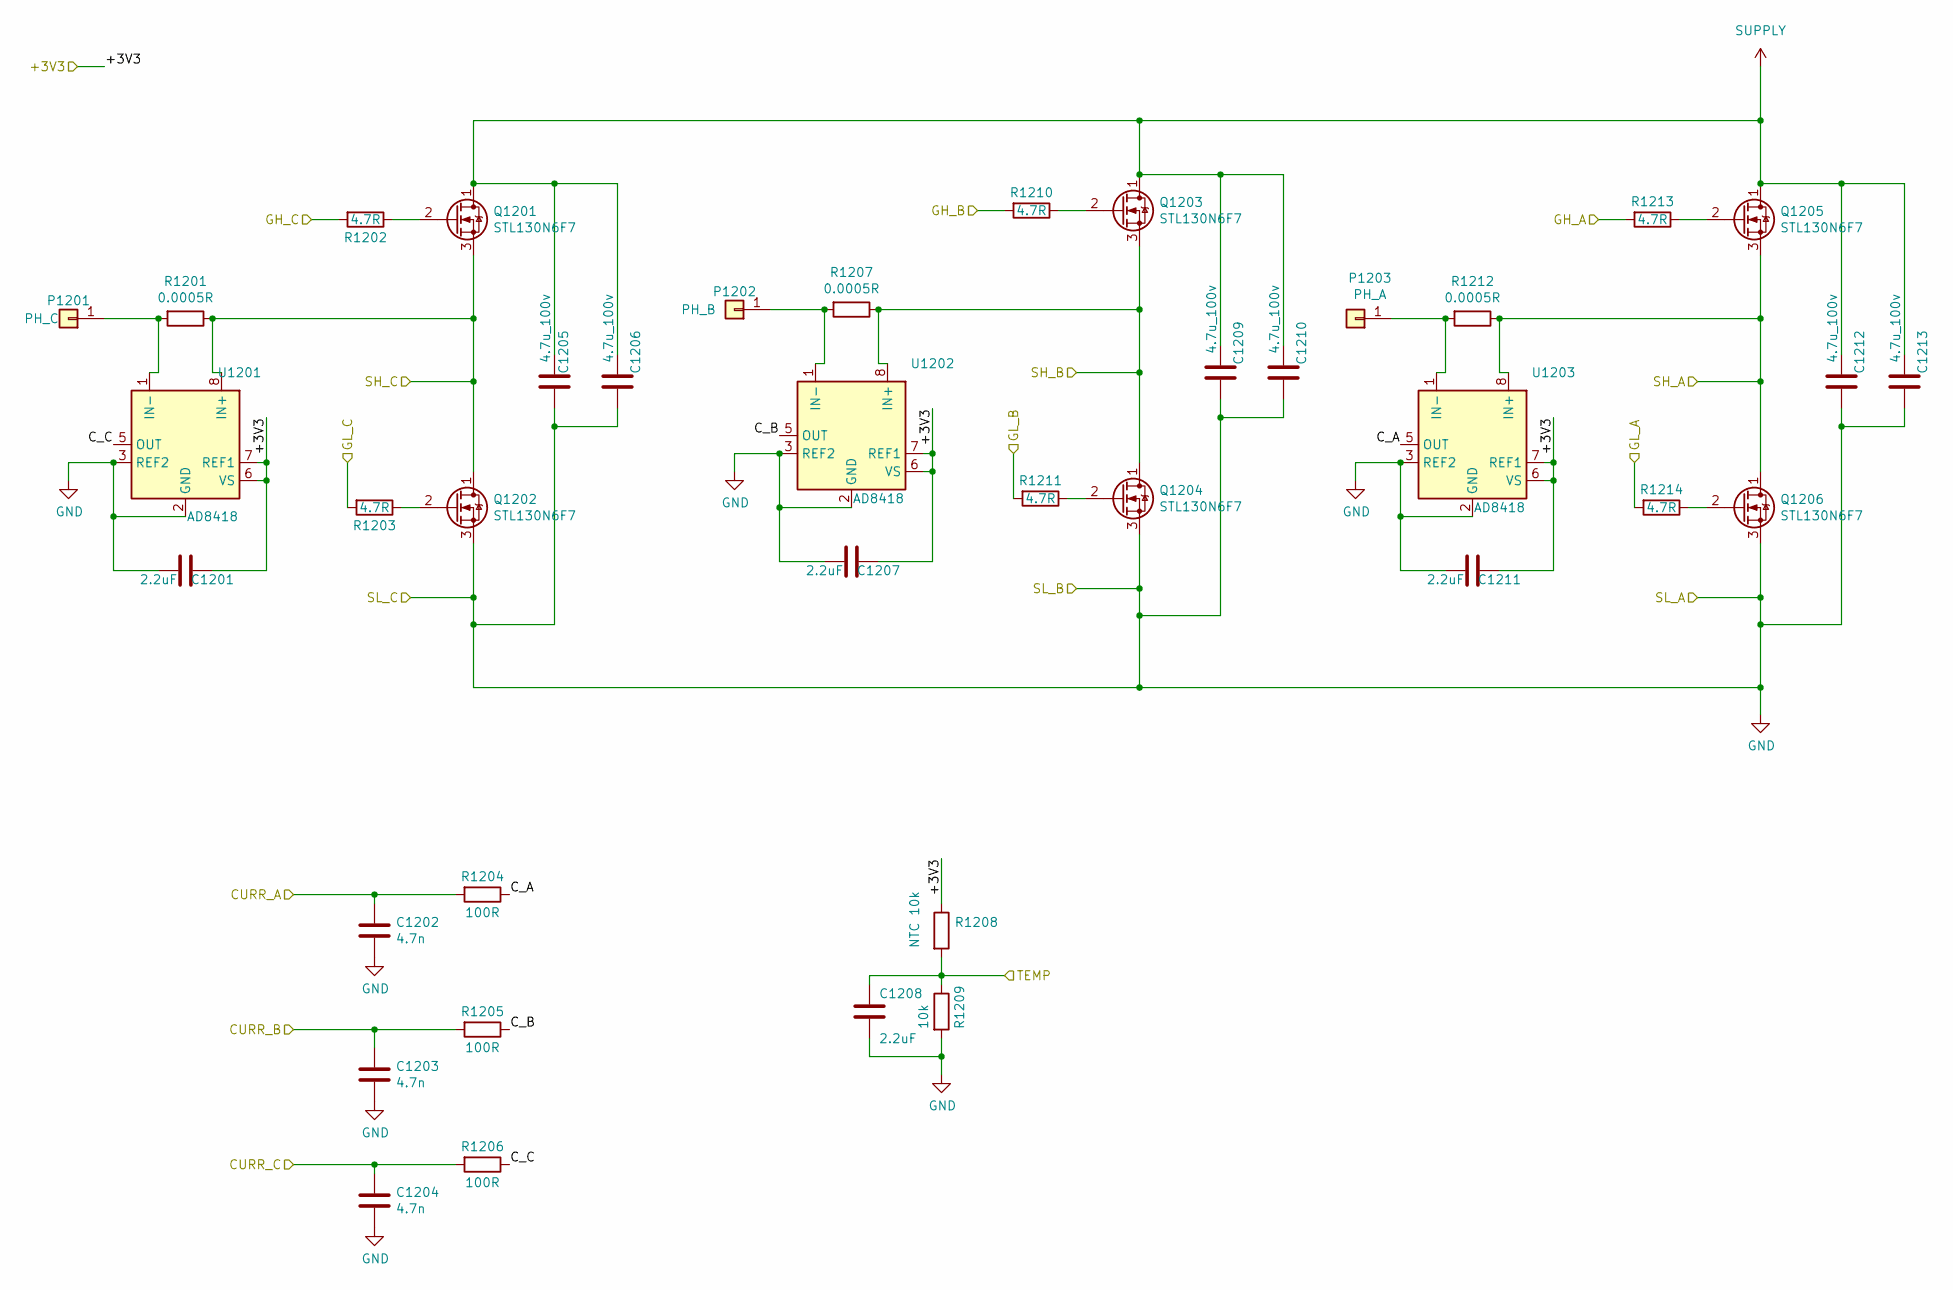
[picture p9: schematic Hbridge.kicad_sch]

Parts:
C1201, C1207, C1208, C1211: 2.2uF; C_0603_1608Metric; LCSC C23630
C1202, C1203, C1204: 4.7n; C_0603_1608Metric; LCSC C53987
C1205, C1206, C1209, C1210, C1212, C1213: 4.7u_100v; C_1210_3225Metric; LCSC C385987
P1201: PH_C; Pin_D1.3mm_L11.0mm_LooseFit; LCSC C7200700
P1202: PH_B; Pin_D1.3mm_L11.0mm_LooseFit; LCSC C7200700
P1203: PH_A; Pin_D1.3mm_L11.0mm_LooseFit; LCSC C7200700
Q1201, Q1202, Q1203, Q1204, Q1205, Q1206: STL130N6F7; NVMFS5C612NL; LCSC C501008
R1201, R1207, R1212: 0.0005R; 2512_SHUNT; LCSC C469426
R1202, R1203, R1210, R1211, R1213, R1214: 4.7R; R_0603_1608Metric; LCSC C23164
R1204, R1205, R1206: 100R; R_0603_1608Metric; LCSC C22775
R1208: NTC 10k; R_0603_1608Metric; LCSC C76589
R1209: 10k; R_0603_1608Metric; LCSC C25804
U1201, U1202, U1203: AD8418; SOIC-8_3.9x4.9mm_P1.27mm; LCSC C495342

Connections:
+3V3a: C1201.1, C1207.1, C1211.1, R1208.1, U1201.6 (VS), U1201.7 (REF1), U1202.6 (VS), U1202.7 (REF1), U1203.6 (VS), U1203.7 (REF1); also elsewhere on the board
/CHa/DRV8301/GH_A: R1213.2; also elsewhere on the board
/CHa/DRV8301/GH_B: R1210.2; also elsewhere on the board
/CHa/DRV8301/GH_C: R1202.2; also elsewhere on the board
/CHa/DRV8301/GL_A: R1214.2; also elsewhere on the board
/CHa/DRV8301/GL_B: R1211.2; also elsewhere on the board
/CHa/DRV8301/GL_C: R1203.2; also elsewhere on the board
/CHa/DRV8301/SH_A: Q1205.3 (S), Q1206.1 (D), R1212.1, U1203.8 (IN+); also elsewhere on the board
/CHa/DRV8301/SH_B: Q1203.3 (S), Q1204.1 (D), R1207.1, U1202.8 (IN+); also elsewhere on the board
/CHa/DRV8301/SH_C: Q1201.3 (S), Q1202.1 (D), R1201.1, U1201.8 (IN+); also elsewhere on the board
/CHa/Hbridge/CURR_A: C1202.1, R1204.2; also elsewhere on the board
/CHa/Hbridge/CURR_B: C1203.1, R1205.2; also elsewhere on the board
/CHa/Hbridge/CURR_C: C1204.1, R1206.2; also elsewhere on the board
/CHa/Hbridge/C_A: R1204.1, U1203.5 (OUT)
/CHa/Hbridge/C_B: R1205.1, U1202.5 (OUT)
/CHa/Hbridge/C_C: R1206.1, U1201.5 (OUT)
/CHa/Hbridge/TEMP: C1208.1, R1208.2, R1209.1; also elsewhere on the board
GND: C1201.2, C1202.2, C1203.2, C1204.2, C1205.2, C1206.2, C1207.2, C1208.2, C1209.2, C1210.2, C1211.2, C1212.2, C1213.2, Q1202.3 (S), Q1204.3 (S), Q1206.3 (S), R1209.2, U1201.2 (GND), U1201.3 (REF2), U1202.2 (GND), U1202.3 (REF2), U1203.2 (GND), U1203.3 (REF2); also elsewhere on the board
unnamed: P1201.1 (Pin_1_1), R1201.2, U1201.1 (IN-)
unnamed: P1202.1 (Pin_1_1), R1207.2, U1202.1 (IN-)
unnamed: P1203.1 (Pin_1_1), R1212.2, U1203.1 (IN-)
unnamed: Q1201.2 (G), R1202.1
unnamed: Q1202.2 (G), R1203.1
unnamed: Q1203.2 (G), R1210.1
unnamed: Q1204.2 (G), R1211.1
unnamed: Q1205.2 (G), R1213.1
unnamed: Q1206.2 (G), R1214.1
SUPPLY: C1205.1, C1206.1, C1209.1, C1210.1, C1212.1, C1213.1, Q1201.1 (D), Q1203.1 (D), Q1205.1 (D); also elsewhere on the board

Parts of its further copies:
C2201, C2207, C2208, C2211: 2.2uF; C_0603_1608Metric; LCSC C23630
C2202, C2203, C2204: 4.7n; C_0603_1608Metric; LCSC C53987
C2205, C2206, C2209, C2210, C2212, C2213: 4.7u_100v; C_1210_3225Metric; LCSC C385987
P2201: PH_C; Pin_D1.3mm_L11.0mm_LooseFit; LCSC C7200700
P2202: PH_B; Pin_D1.3mm_L11.0mm_LooseFit; LCSC C7200700
P2203: PH_A; Pin_D1.3mm_L11.0mm_LooseFit; LCSC C7200700
Q2201, Q2202, Q2203, Q2204, Q2205, Q2206: STL130N6F7; NVMFS5C612NL; LCSC C501008
R2201, R2207, R2212: 0.0005R; 2512_SHUNT; LCSC C469426
R2202, R2203, R2210, R2211, R2213, R2214: 4.7R; R_0603_1608Metric; LCSC C23164
R2204, R2205, R2206: 100R; R_0603_1608Metric; LCSC C22775
R2208: NTC 10k; R_0603_1608Metric; LCSC C76589
R2209: 10k; R_0603_1608Metric; LCSC C25804
U2201, U2202, U2203: AD8418; SOIC-8_3.9x4.9mm_P1.27mm; LCSC C495342

Connections of its further copies:
+3V3b: C2201.1, C2207.1, C2211.1, R2208.1, U2201.6 (VS), U2201.7 (REF1), U2202.6 (VS), U2202.7 (REF1), U2203.6 (VS), U2203.7 (REF1); also elsewhere on the board
/CHb/DRV8301/GH_A: R2213.2; also elsewhere on the board
/CHb/DRV8301/GH_B: R2210.2; also elsewhere on the board
/CHb/DRV8301/GH_C: R2202.2; also elsewhere on the board
/CHb/DRV8301/GL_A: R2214.2; also elsewhere on the board
/CHb/DRV8301/GL_B: R2211.2; also elsewhere on the board
/CHb/DRV8301/GL_C: R2203.2; also elsewhere on the board
/CHb/DRV8301/SH_A: Q2205.3 (S), Q2206.1 (D), R2212.1, U2203.8 (IN+); also elsewhere on the board
/CHb/DRV8301/SH_B: Q2203.3 (S), Q2204.1 (D), R2207.1, U2202.8 (IN+); also elsewhere on the board
/CHb/DRV8301/SH_C: Q2201.3 (S), Q2202.1 (D), R2201.1, U2201.8 (IN+); also elsewhere on the board
/CHb/Hbridge/CURR_A: C2202.1, R2204.2; also elsewhere on the board
/CHb/Hbridge/CURR_B: C2203.1, R2205.2; also elsewhere on the board
/CHb/Hbridge/CURR_C: C2204.1, R2206.2; also elsewhere on the board
/CHb/Hbridge/C_A: R2204.1, U2203.5 (OUT)
/CHb/Hbridge/C_B: R2205.1, U2202.5 (OUT)
/CHb/Hbridge/C_C: R2206.1, U2201.5 (OUT)
/CHb/Hbridge/TEMP: C2208.1, R2208.2, R2209.1; also elsewhere on the board
GND: C2201.2, C2202.2, C2203.2, C2204.2, C2205.2, C2206.2, C2207.2, C2208.2, C2209.2, C2210.2, C2211.2, C2212.2, C2213.2, Q2202.3 (S), Q2204.3 (S), Q2206.3 (S), R2209.2, U2201.2 (GND), U2201.3 (REF2), U2202.2 (GND), U2202.3 (REF2), U2203.2 (GND), U2203.3 (REF2); also elsewhere on the board
unnamed: P2201.1 (Pin_1_1), R2201.2, U2201.1 (IN-)
unnamed: P2202.1 (Pin_1_1), R2207.2, U2202.1 (IN-)
unnamed: P2203.1 (Pin_1_1), R2212.2, U2203.1 (IN-)
unnamed: Q2201.2 (G), R2202.1
unnamed: Q2202.2 (G), R2203.1
unnamed: Q2203.2 (G), R2210.1
unnamed: Q2204.2 (G), R2211.1
unnamed: Q2205.2 (G), R2213.1
unnamed: Q2206.2 (G), R2214.1
SUPPLY: C2205.1, C2206.1, C2209.1, C2210.1, C2212.1, C2213.1, Q2201.1 (D), Q2203.1 (D), Q2205.1 (D); also elsewhere on the board

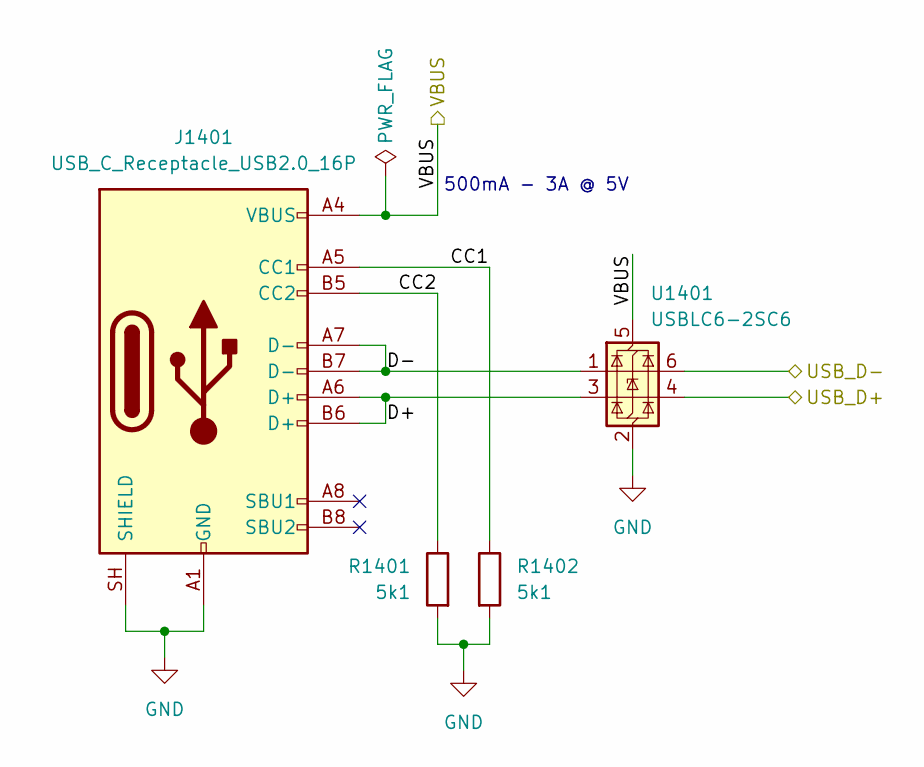
[picture p10: schematic USB.kicad_sch]

Parts:
J1401: USB_C_Receptacle_USB2.0_16P; USB_C_Receptacle_HRO_TYPE-C-31-M-12; LCSC part no. C165948
R1401, R1402: 5k1; R_0805_2012Metric_Pad1.20x1.40mm_HandSolder; LCSC part no. C84375
U1401: USBLC6-2SC6; SOT-23-6; LCSC part no. C2827654

Connections:
/CHa/USB/CC1: J1401.A5 (CC1), R1402.1
/CHa/USB/CC2: J1401.B5 (CC2), R1401.1
/CHa/USB/D+: J1401.A6 (D+), J1401.B6 (D+), U1401.3 (I/O2)
/CHa/USB/D-: J1401.A7 (D-), J1401.B7 (D-), U1401.1 (I/O1)
/CHa/USB/USB_D+: U1401.4 (I/O2); also elsewhere on the board
/CHa/USB/USB_D-: U1401.6 (I/O1); also elsewhere on the board
/CHa/USB/VBUS: J1401.A4 (VBUS), J1401.A9 (VBUS), J1401.B4 (VBUS), J1401.B9 (VBUS), U1401.5 (VBUS); also elsewhere on the board
GND: J1401.A1 (GND), J1401.A12 (GND), J1401.B1 (GND), J1401.B12 (GND), J1401.SH (SHIELD), R1401.2, R1402.2, U1401.2 (GND); also elsewhere on the board

Parts of its further copies:
J2401: USB_C_Receptacle_USB2.0_16P; USB_C_Receptacle_HRO_TYPE-C-31-M-12; LCSC part no. C165948
R2401, R2402: 5k1; R_0805_2012Metric_Pad1.20x1.40mm_HandSolder; LCSC part no. C84375
U2401: USBLC6-2SC6; SOT-23-6; LCSC part no. C2827654

Connections of its further copies:
/CHb/USB/CC1: J2401.A5 (CC1), R2402.1
/CHb/USB/CC2: J2401.B5 (CC2), R2401.1
/CHb/USB/D+: J2401.A6 (D+), J2401.B6 (D+), U2401.3 (I/O2)
/CHb/USB/D-: J2401.A7 (D-), J2401.B7 (D-), U2401.1 (I/O1)
/CHb/USB/USB_D+: U2401.4 (I/O2); also elsewhere on the board
/CHb/USB/USB_D-: U2401.6 (I/O1); also elsewhere on the board
/CHb/USB/VBUS: J2401.A4 (VBUS), J2401.A9 (VBUS), J2401.B4 (VBUS), J2401.B9 (VBUS), U2401.5 (VBUS); also elsewhere on the board
GND: J2401.A1 (GND), J2401.A12 (GND), J2401.B1 (GND), J2401.B12 (GND), J2401.SH (SHIELD), R2401.2, R2402.2, U2401.2 (GND); also elsewhere on the board

Notes on the sheet:
500mA - 3A @ 5V

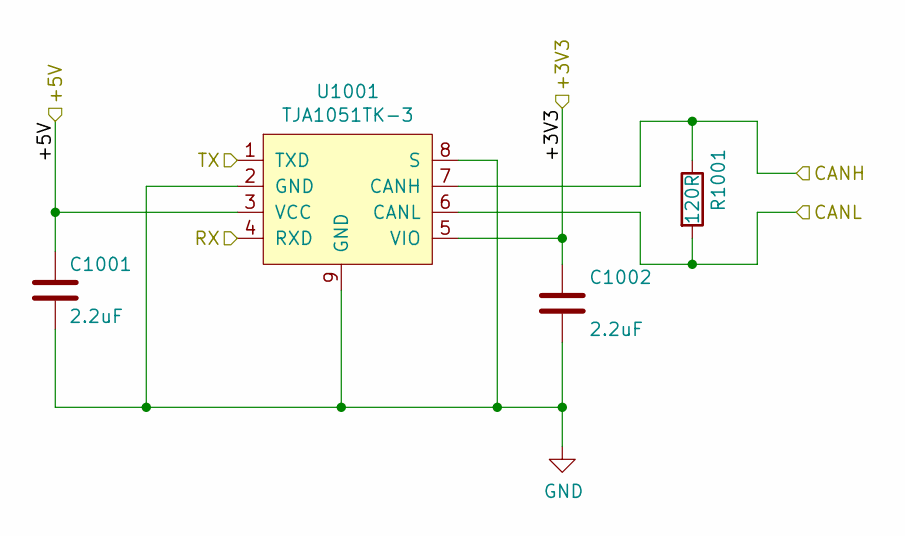
[picture p11: schematic CAN.kicad_sch]

Parts:
C1001, C1002: 2.2uF; C_0603_1608Metric; LCSC C23630
R1001: 120R; R_0603_1608Metric; LCSC C22787
U1001: TJA1051TK-3; DFN-8-1EP_3x3mm_P0.65mm_EP1.55x2.4mm; LCSC C124020

Connections:
+3V3a: C1002.1, U1001.5 (VIO); also elsewhere on the board
+5Va: C1001.1, U1001.3 (VCC); also elsewhere on the board
/CHa/CAN/RX: U1001.4 (RXD); also elsewhere on the board
/CHa/CAN/TX: U1001.1 (TXD); also elsewhere on the board
/CHa/CANH: R1001.1, U1001.7 (CANH); also elsewhere on the board
/CHa/CANL: R1001.2, U1001.6 (CANL); also elsewhere on the board
GND: C1001.2, C1002.2, U1001.2 (GND), U1001.8 (S), U1001.9 (GND); also elsewhere on the board

Parts of its further copies:
C2001, C2002: 2.2uF; C_0603_1608Metric; LCSC C23630
R2001: 120R; R_0603_1608Metric; LCSC C22787
U2001: TJA1051TK-3; DFN-8-1EP_3x3mm_P0.65mm_EP1.55x2.4mm; LCSC C124020

Connections of its further copies:
+3V3b: C2002.1, U2001.5 (VIO); also elsewhere on the board
+5Vb: C2001.1, U2001.3 (VCC); also elsewhere on the board
/CHa/CANH: R2001.1, U2001.7 (CANH); also elsewhere on the board
/CHa/CANL: R2001.2, U2001.6 (CANL); also elsewhere on the board
/CHb/CAN/RX: U2001.4 (RXD); also elsewhere on the board
/CHb/CAN/TX: U2001.1 (TXD); also elsewhere on the board
GND: C2001.2, C2002.2, U2001.2 (GND), U2001.8 (S), U2001.9 (GND); also elsewhere on the board

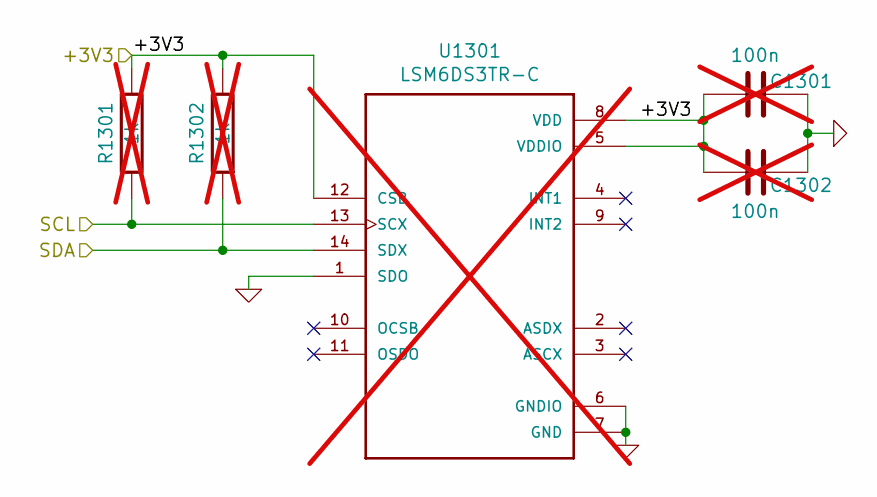
[picture p12: schematic IMU.kicad_sch]

Parts:
C1301, C1302: 100n; C_0603_1608Metric; LCSC C14663; not fitted
R1301, R1302: 1k; R_0603_1608Metric; LCSC C21190; not fitted
U1301: LSM6DS3TR-C; Bosch_LGA-14_3x2.5mm_P0.5mm; LCSC C967633; not fitted

Connections:
+3V3a: C1301.2, C1302.2, R1301.1, R1302.2, U1301.5 (VDDIO), U1301.8 (VDD), U1301.12 (CSB); also elsewhere on the board
/CHa/IMU/SCL: R1301.2, U1301.13 (SCX); also elsewhere on the board
/CHa/IMU/SDA: R1302.1, U1301.14 (SDX); also elsewhere on the board
GND: C1301.1, C1302.1, U1301.1 (SDO), U1301.6 (GNDIO), U1301.7 (GND); also elsewhere on the board

Parts of its further copies:
C2301, C2302: 100n; C_0603_1608Metric; LCSC C14663; not fitted
R2301, R2302: 1k; R_0603_1608Metric; LCSC C21190; not fitted
U2301: LSM6DS3TR-C; Bosch_LGA-14_3x2.5mm_P0.5mm; LCSC C967633; not fitted

Connections of its further copies:
+3V3b: C2301.2, C2302.2, R2301.1, R2302.2, U2301.5 (VDDIO), U2301.8 (VDD), U2301.12 (CSB); also elsewhere on the board
/CHb/IMU/SCL: R2301.2, U2301.13 (SCX); also elsewhere on the board
/CHb/IMU/SDA: R2302.1, U2301.14 (SDX); also elsewhere on the board
GND: C2301.1, C2302.1, U2301.1 (SDO), U2301.6 (GNDIO), U2301.7 (GND); also elsewhere on the board

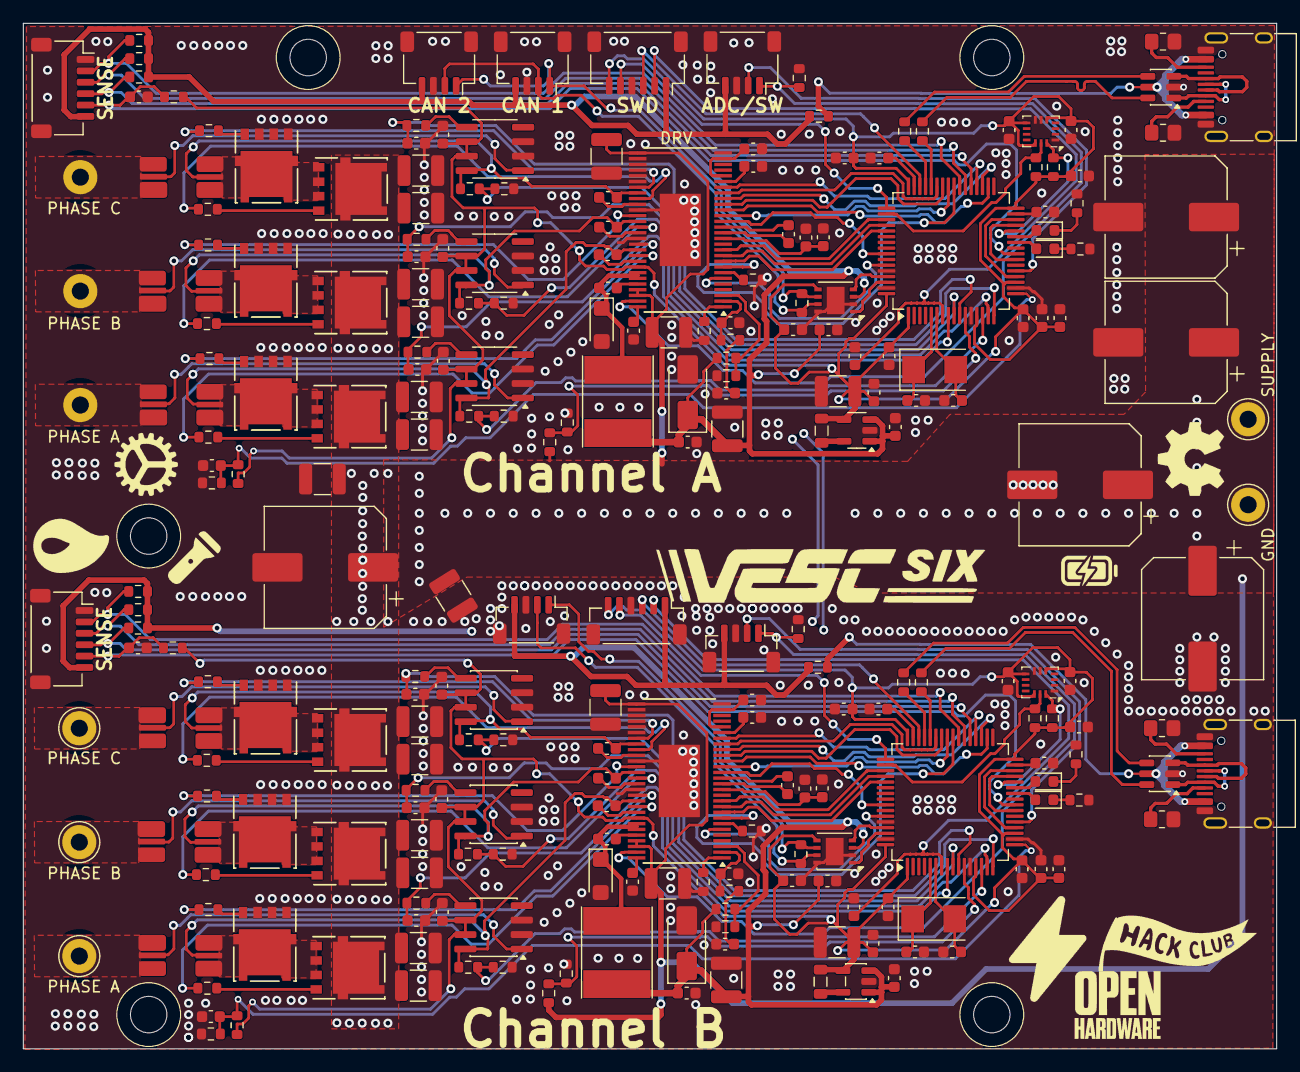
[picture p13: board VESC6_OPEN_HARDWARE.kicad_pcb from above]

Board: 4 copper layers, 110.0 x 90.0 mm, 255 parts (0 on the bottom side), 188 nets.
