Tomas-Kuchta-FPV/VESC6_OPEN_HARDWARE/(commit log)

2026-09-14 Update README with board trace and Gerber file details
    Added information about board trace requirements and Gerber file modifications.
2026-10-24 added a USB-C connector and bumped the KiCAD version to 10
2026-10-25 prep for chaneling. fixed the connector references, added cha to this schematic.
